nandgate/Homebrew-HW/readme.md

Hardware files for the 8-bit homebrew project.

* Each folder contains the KiCad project for a processor/board.
* Under the PLD there is a folder with the WinCUPL projects for the PLD for each board.
