nandgate/Homebrew-HW/CPU_TESTER/CPU_TESTER.pdf

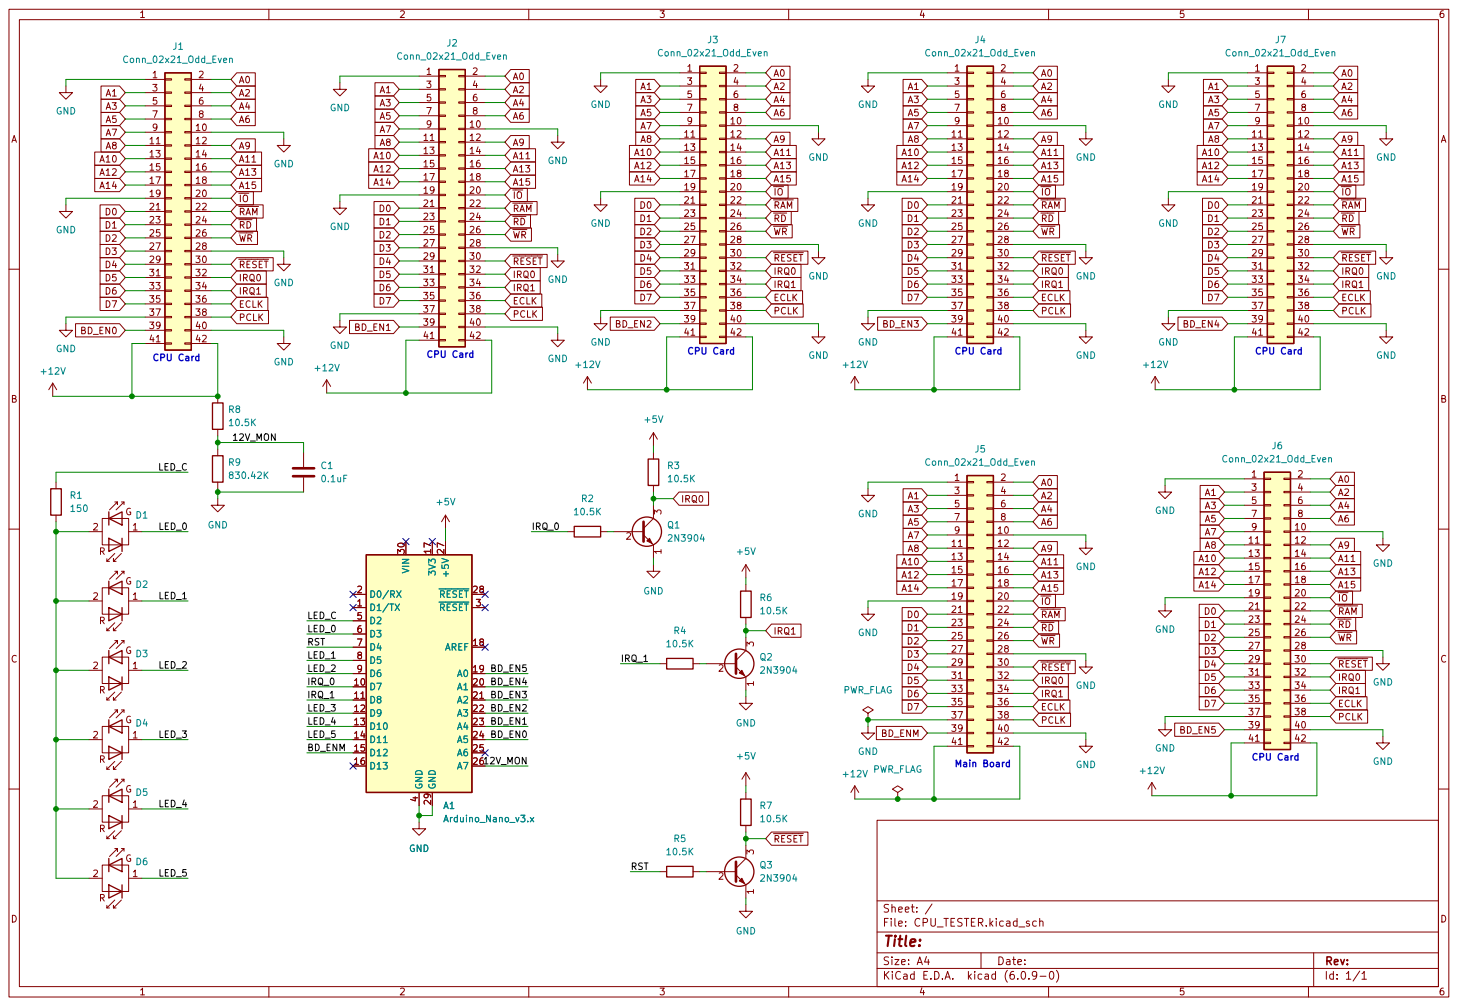
[picture p1: page 1]

J2 Conn_02x21_Odd_Even GND GND GND GND
