nandgate/Homebrew-HW/cpu8085/cpu8085.pdf

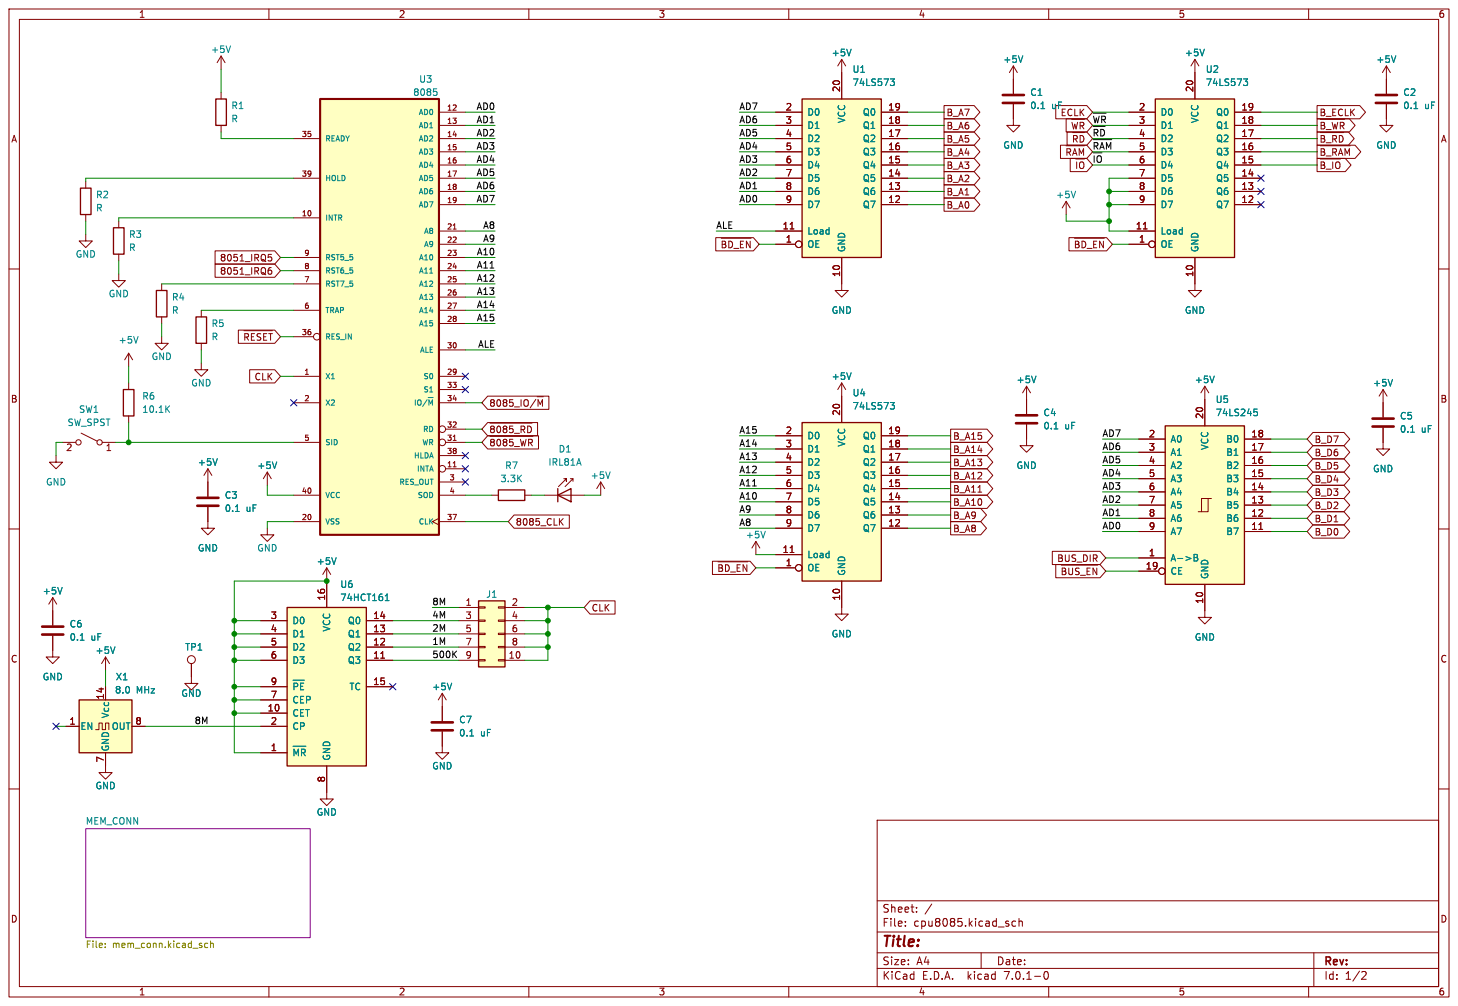
[picture p2: page 1]

Id: 1/2 Title: File: cpu8085.kicad_sch Sheet: / MEM_CONN

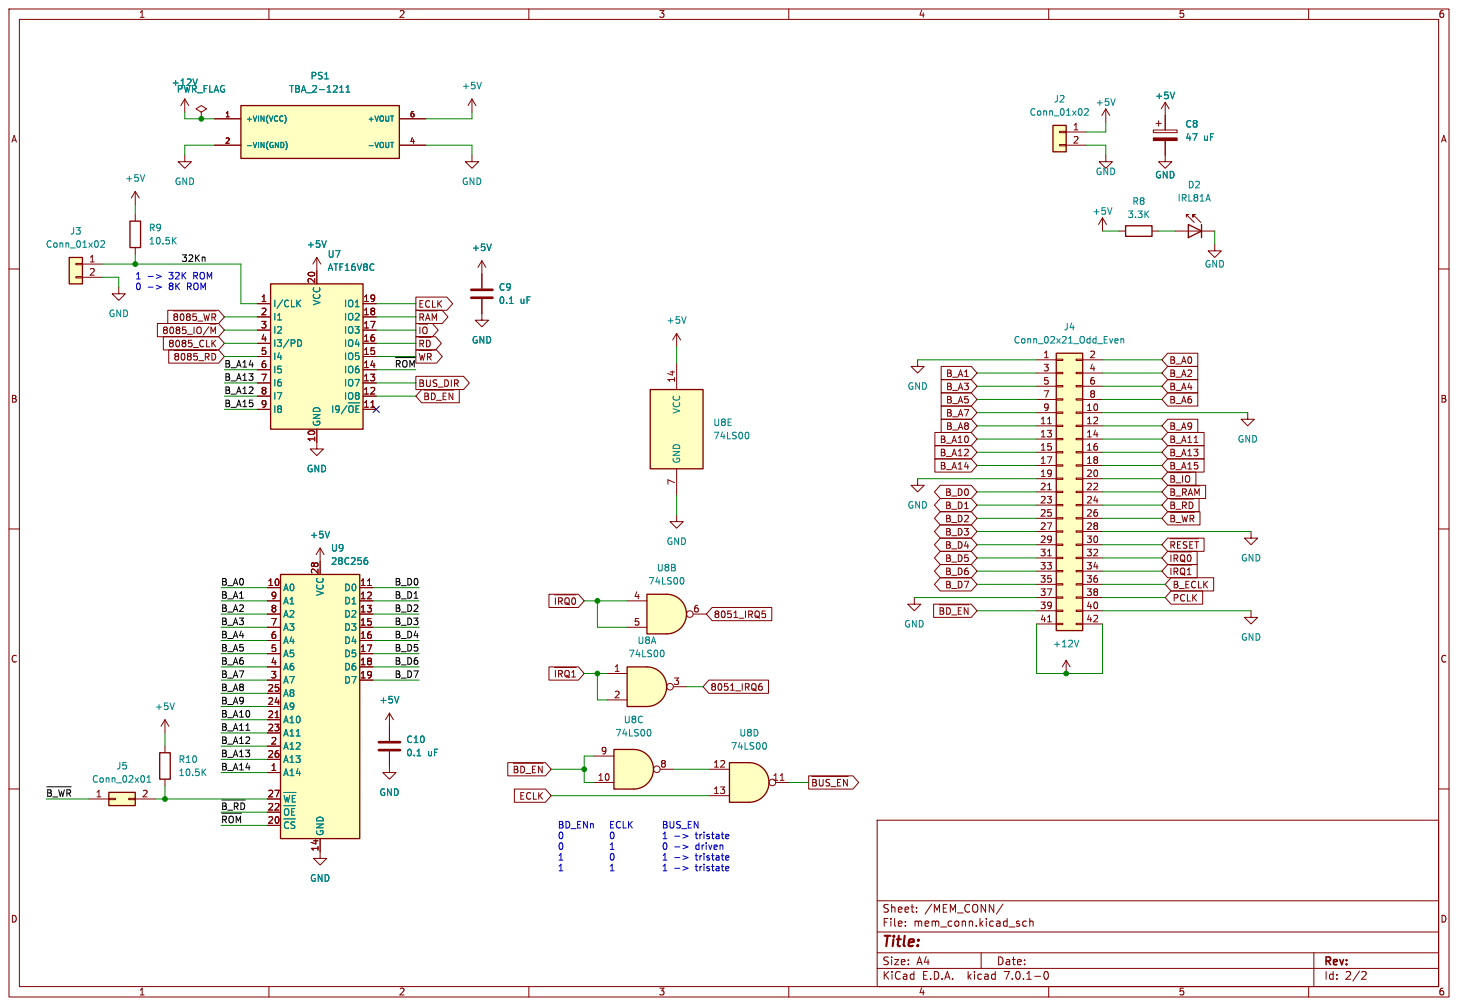
[picture p3: page 2]
