nandgate/Homebrew-HW/cpu6502/cpu6502.pdf

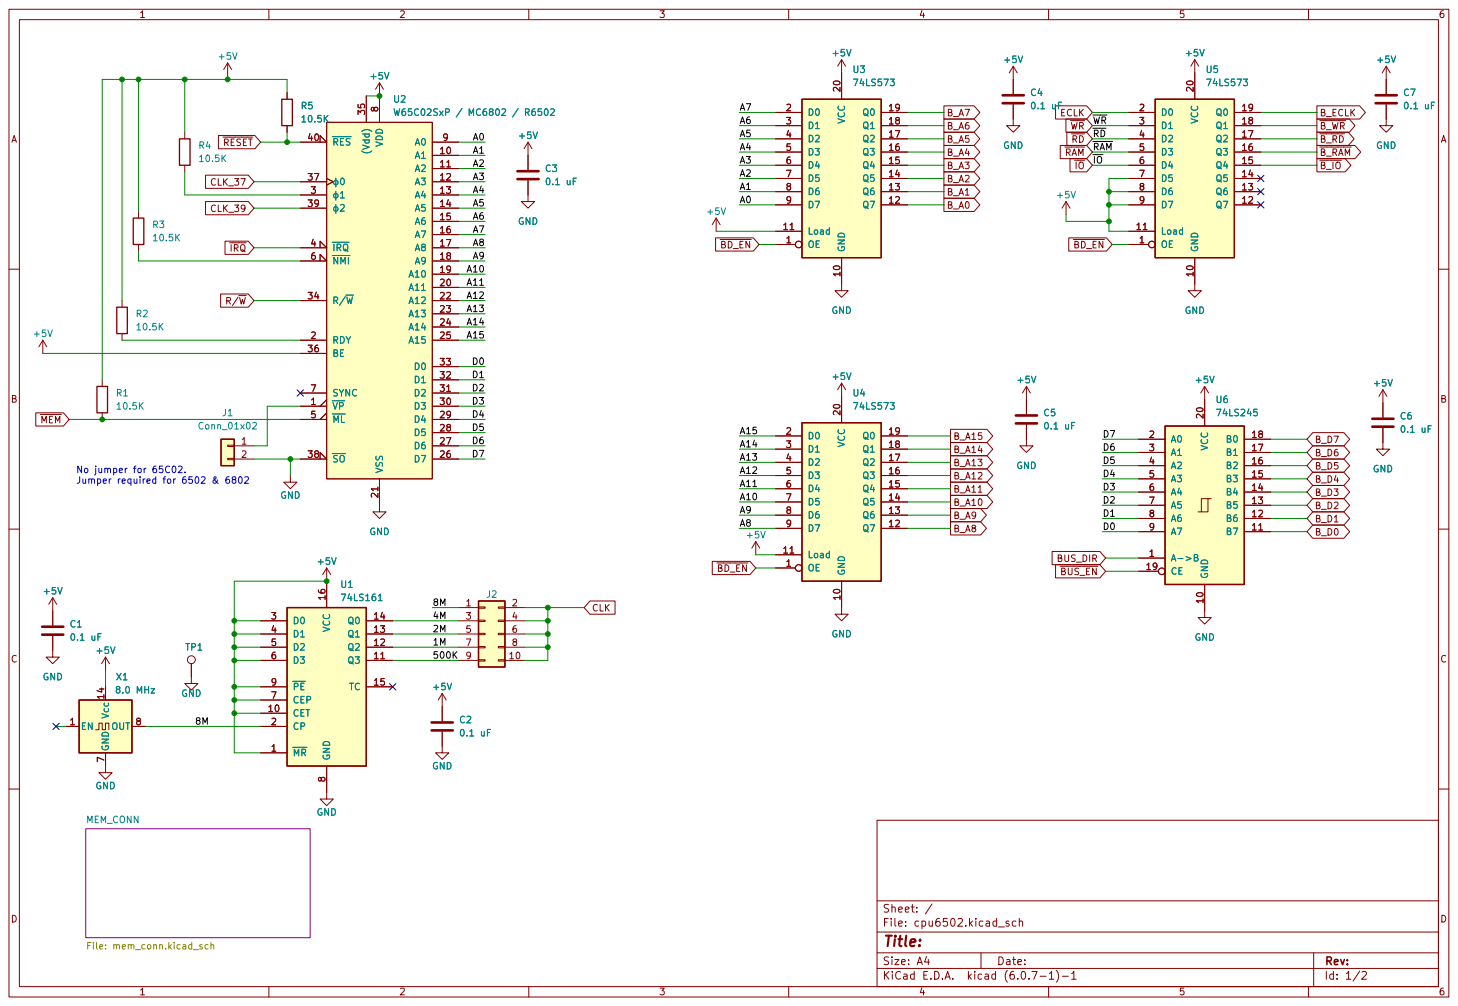
[picture p4: page 1]

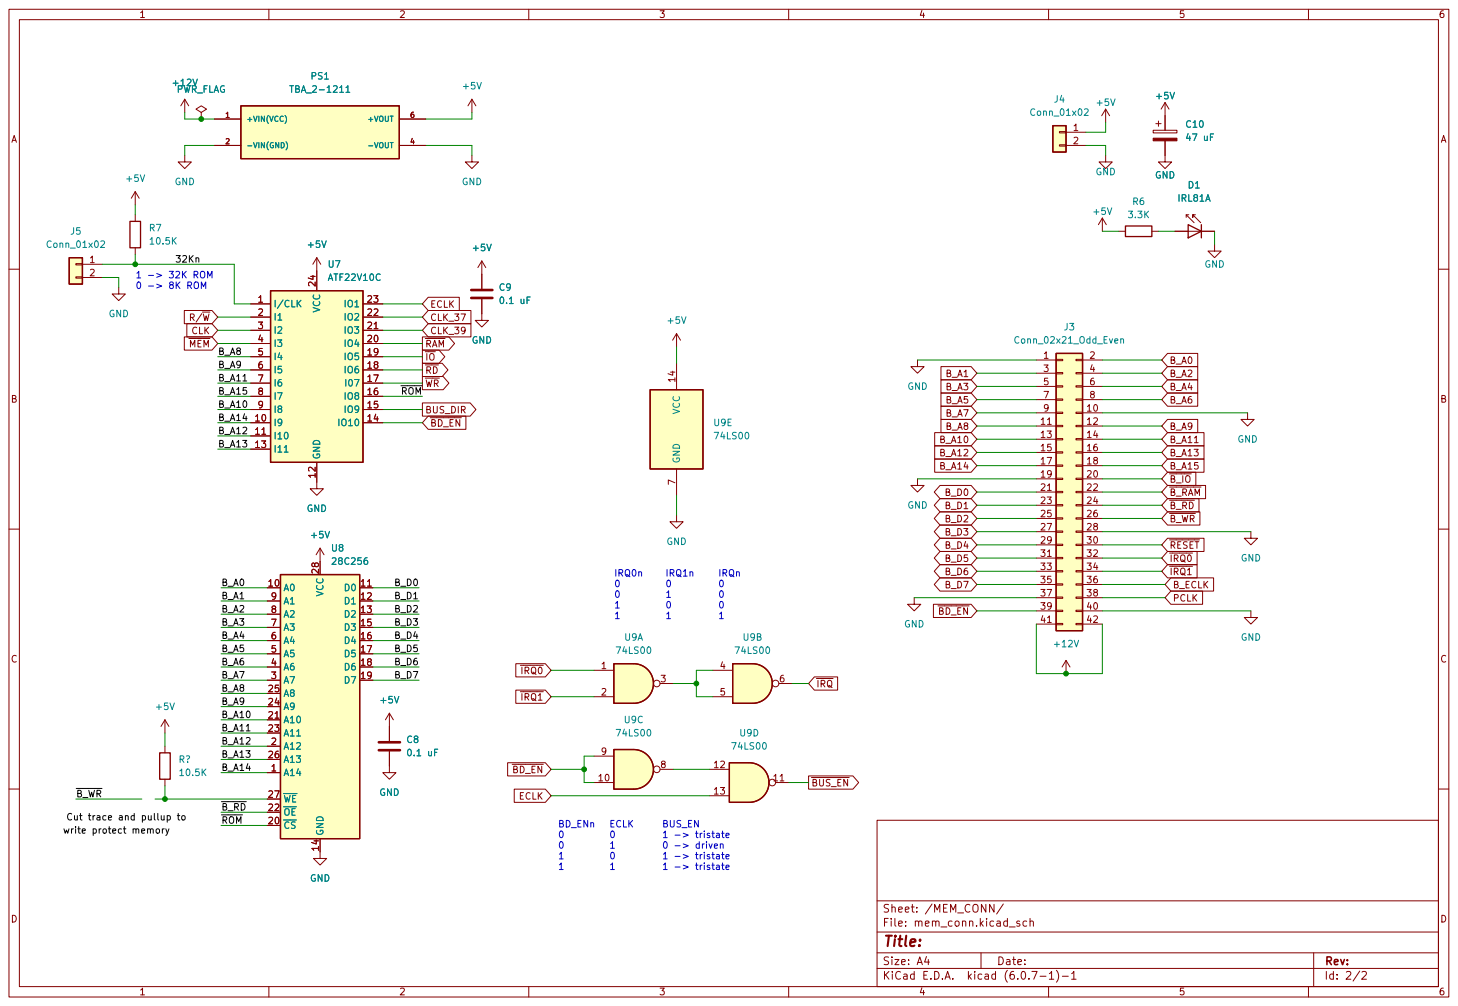
[picture p5: page 2]

J3 Conn_02x21_Odd_Even +12V GND GND GND GND

Cut trace and pullup to
write protect memory
