nandgate/Homebrew-HW/cpuZ80/cpuZ80.pdf

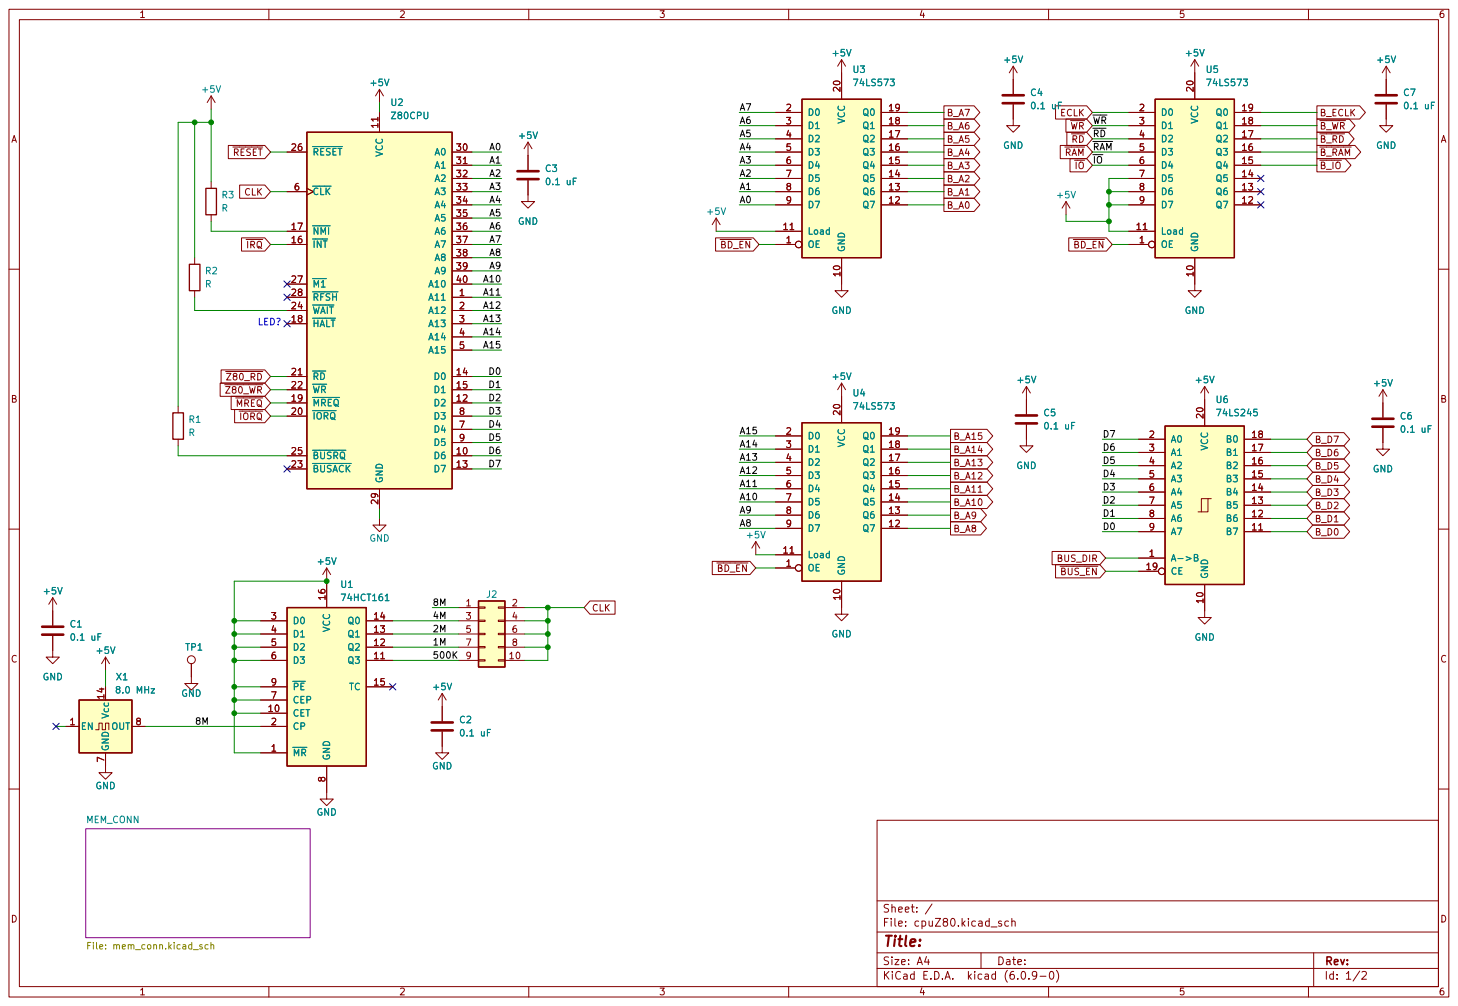
[picture p6: page 1]

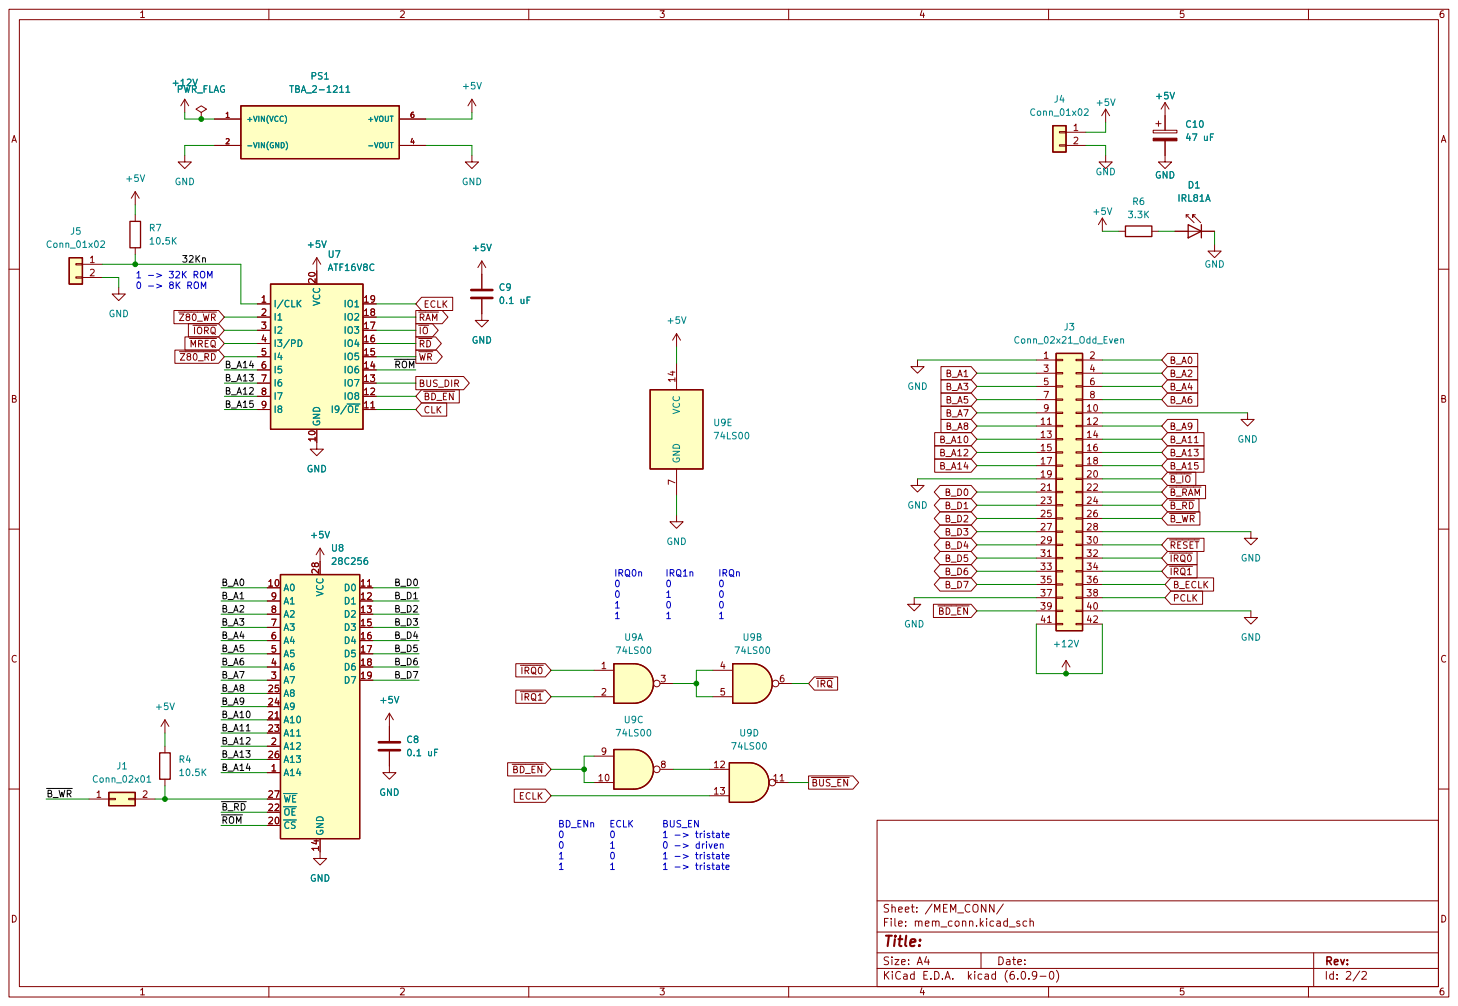
[picture p7: page 2]
