nandgate/Homebrew-HW/cpu8085/cpu8085.kicad_pcb

## KiCad design cpu8085/cpu8085.kicad_pcb (2023-04-04)

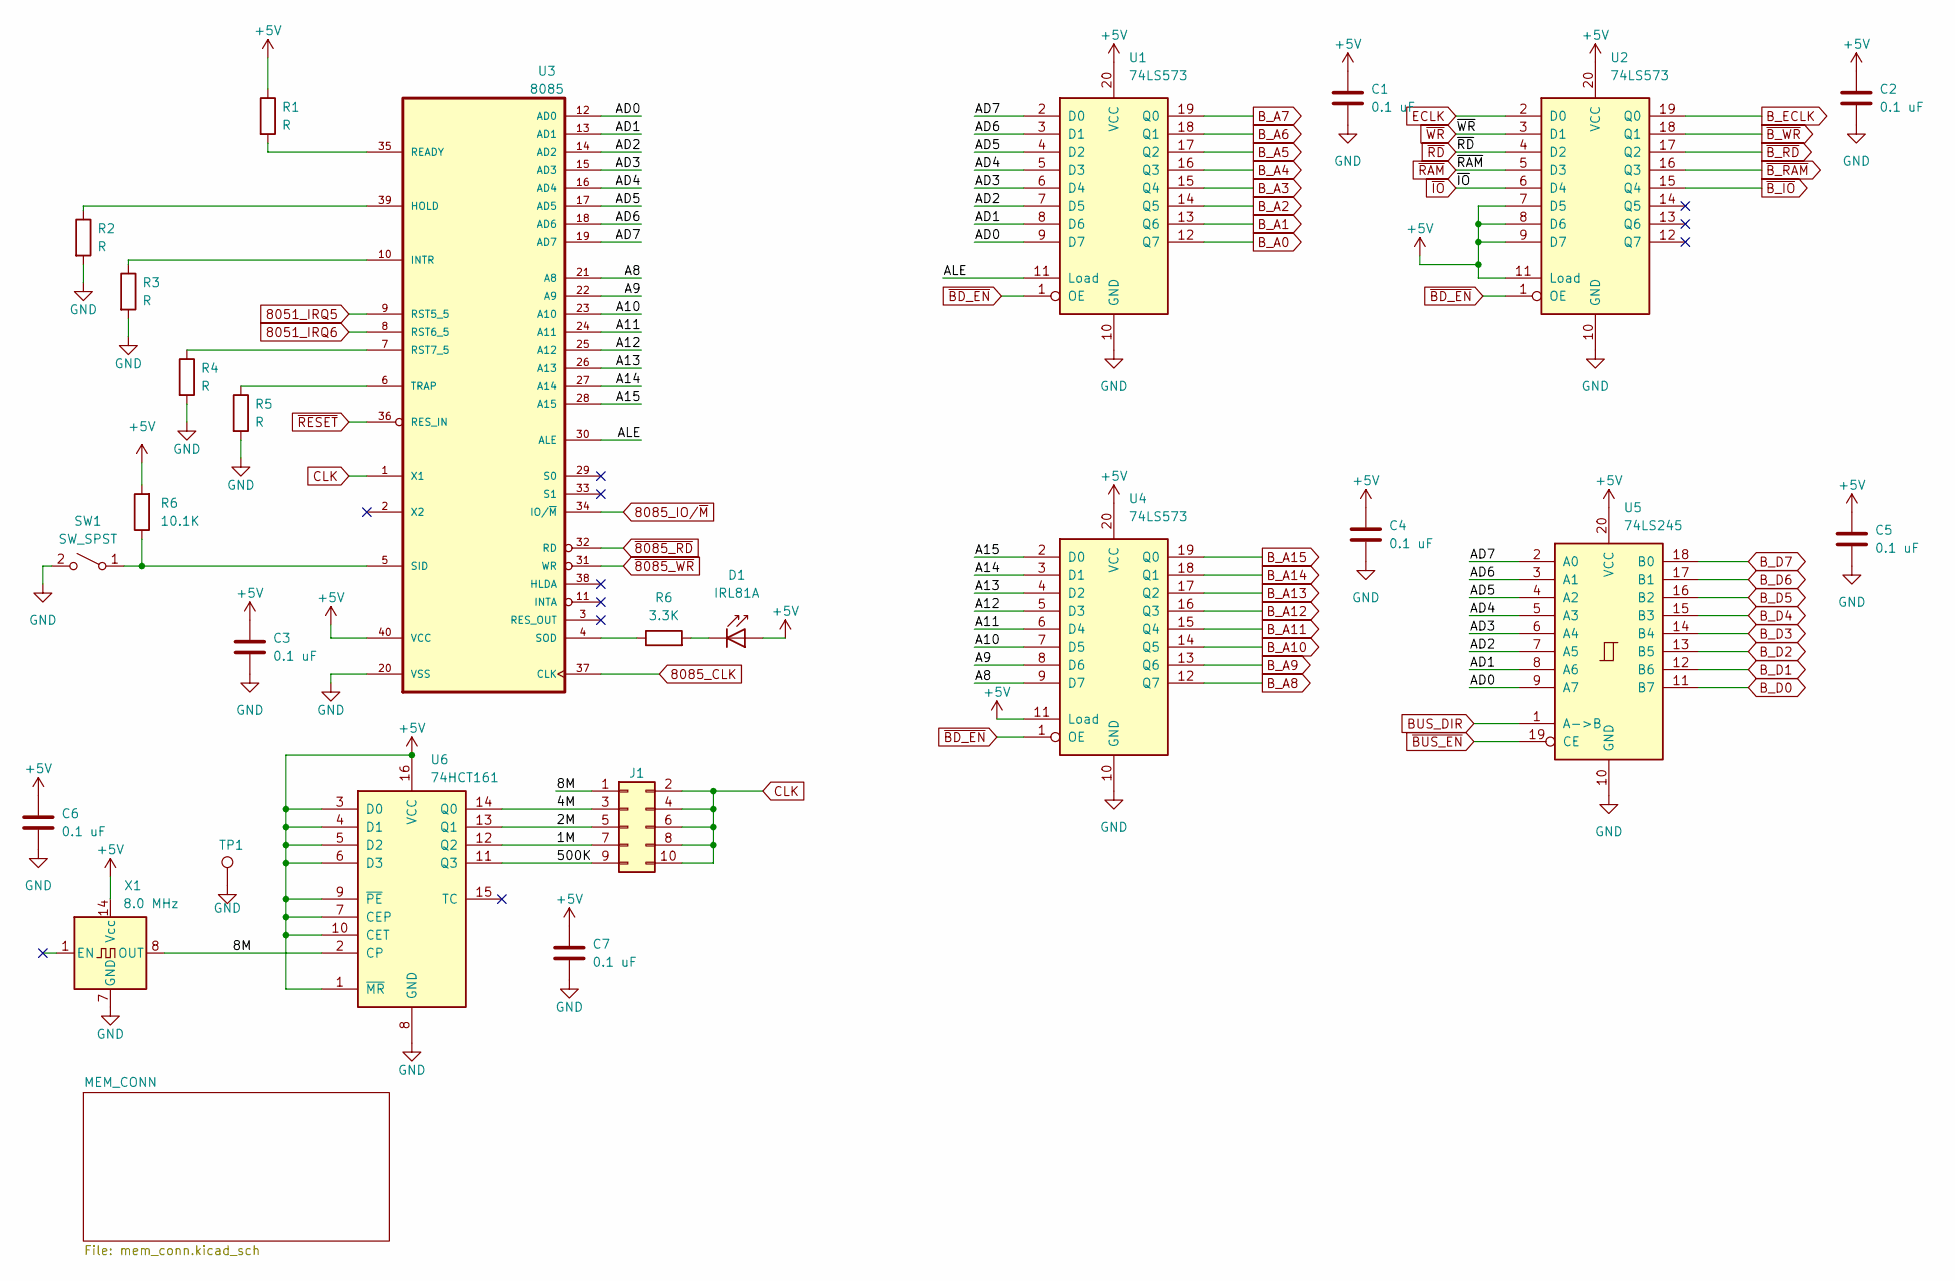
[picture p10: schematic cpu8085.kicad_sch]

Parts:
C1, C2, C3, C4, C5, C6, C7: 0.1 uF; C_Rect_L7.2mm_W3.0mm_P5.00mm_FKS2_FKP2_MKS2_MKP2
D1: IRL81A; LED_D5.0mm
J1: Conn_02x05_Odd_Even; PinHeader_2x05_P2.54mm_Vertical
R1, R2, R3, R4, R5: R; R_Axial_DIN0207_L6.3mm_D2.5mm_P10.16mm_Horizontal
R6: 10.1K; R_Axial_DIN0207_L6.3mm_D2.5mm_P10.16mm_Horizontal
SW1: SW_SPST; SW_DIP_SPSTx01_Slide_9.78x4.72mm_W7.62mm_P2.54mm
TP1: TestPoint; TestPoint_Pad_2.0x2.0mm
U1, U2, U4: 74LS573; DIP-20_W7.62mm
U3: 8085; DIP-40_W15.24mm_Socket
U5: 74LS245; DIP-20_W7.62mm
U6: 74HCT161; DIP-16_W7.62mm
X1: 8.0 MHz; Oscillator_DIP-14

Connections:
8051_IRQ5: U3.9 (RST5_5); also elsewhere on the board
8051_IRQ6: U3.8 (RST6_5); also elsewhere on the board
8085_CLK: U3.37 (CLK); also elsewhere on the board
8085_IO/~M: U3.34 (IO/~M); also elsewhere on the board
/1M: J1.7, U6.12 (Q2)
/2M: J1.5, U6.13 (Q1)
/4M: J1.3, U6.14 (Q0)
/8M: J1.1, U6.2 (CP), X1.8 (OUT)
/500K: J1.9, U6.11 (Q3)
/A8: U3.21 (A8), U4.9 (D7)
/A9: U3.22 (A9), U4.8 (D6)
/A10: U3.23 (A10), U4.7 (D5)
/A11: U3.24 (A11), U4.6 (D4)
/A12: U3.25 (A12), U4.5 (D3)
/A13: U3.26 (A13), U4.4 (D2)
/A14: U3.27 (A14), U4.3 (D1)
/A15: U3.28 (A15), U4.2 (D0)
/AD0: U1.9 (D7), U3.12 (AD0), U5.9 (A7)
/AD1: U1.8 (D6), U3.13 (AD1), U5.8 (A6)
/AD2: U1.7 (D5), U3.14 (AD2), U5.7 (A5)
/AD3: U1.6 (D4), U3.15 (AD3), U5.6 (A4)
/AD4: U1.5 (D3), U3.16 (AD4), U5.5 (A3)
/AD5: U1.4 (D2), U3.17 (AD5), U5.4 (A2)
/AD6: U1.3 (D1), U3.18 (AD6), U5.3 (A1)
/AD7: U1.2 (D0), U3.19 (AD7), U5.2 (A0)
/ALE: U1.11 (Load), U3.30 (ALE)
BUS_DIR: U5.1 (A->B); also elsewhere on the board
B_A0: U1.12 (Q7); also elsewhere on the board
B_A1: U1.13 (Q6); also elsewhere on the board
B_A2: U1.14 (Q5); also elsewhere on the board
B_A3: U1.15 (Q4); also elsewhere on the board
B_A4: U1.16 (Q3); also elsewhere on the board
B_A5: U1.17 (Q2); also elsewhere on the board
B_A6: U1.18 (Q1); also elsewhere on the board
B_A7: U1.19 (Q0); also elsewhere on the board
B_A8: U4.12 (Q7); also elsewhere on the board
B_A9: U4.13 (Q6); also elsewhere on the board
B_A10: U4.14 (Q5); also elsewhere on the board
B_A11: U4.15 (Q4); also elsewhere on the board
B_A12: U4.16 (Q3); also elsewhere on the board
B_A13: U4.17 (Q2); also elsewhere on the board
B_A14: U4.18 (Q1); also elsewhere on the board
B_A15: U4.19 (Q0); also elsewhere on the board
B_D0: U5.11 (B7); also elsewhere on the board
B_D1: U5.12 (B6); also elsewhere on the board
B_D2: U5.13 (B5); also elsewhere on the board
B_D3: U5.14 (B4); also elsewhere on the board
B_D4: U5.15 (B3); also elsewhere on the board
B_D5: U5.16 (B2); also elsewhere on the board
B_D6: U5.17 (B1); also elsewhere on the board
B_D7: U5.18 (B0); also elsewhere on the board
B_ECLK: U2.19 (Q0); also elsewhere on the board
CLK: J1.2, J1.4, J1.6, J1.8, J1.10, U3.1 (X1)
ECLK: U2.2 (D0); also elsewhere on the board
GND: C1.2, C2.2, C3.2, C4.2, C5.2, C6.2, C7.2, R2.2, R3.2, R4.2, R5.2, SW1.2 (B), TP1.1, U1.10 (GND), U2.10 (GND), U3.20 (VSS), U4.10 (GND), U5.10 (GND), U6.8 (GND), X1.7 (GND); also elsewhere on the board
unnamed: R2.1, U3.39 (HOLD)
unnamed: R3.1, U3.10 (INTR)
unnamed: R1.2, U3.35 (READY)
unnamed: R4.1, U3.7 (RST7_5)
unnamed: R5.1, U3.6 (TRAP)
~8085_RD: U3.32 (RD); also elsewhere on the board
~8085_WR: U3.31 (WR); also elsewhere on the board
~BD_EN: U1.1 (OE), U2.1 (OE), U4.1 (OE); also elsewhere on the board
~BUS_EN: U5.19 (CE); also elsewhere on the board
~B_IO: U2.15 (Q4); also elsewhere on the board
~B_RAM: U2.16 (Q3); also elsewhere on the board
~B_RD: U2.17 (Q2); also elsewhere on the board
~B_WR: U2.18 (Q1); also elsewhere on the board
~IO: U2.6 (D4); also elsewhere on the board
~RAM: U2.5 (D3); also elsewhere on the board
~RD: U2.4 (D2); also elsewhere on the board
~RESET: U3.36 (RES_IN); also elsewhere on the board
~WR: U2.3 (D1); also elsewhere on the board

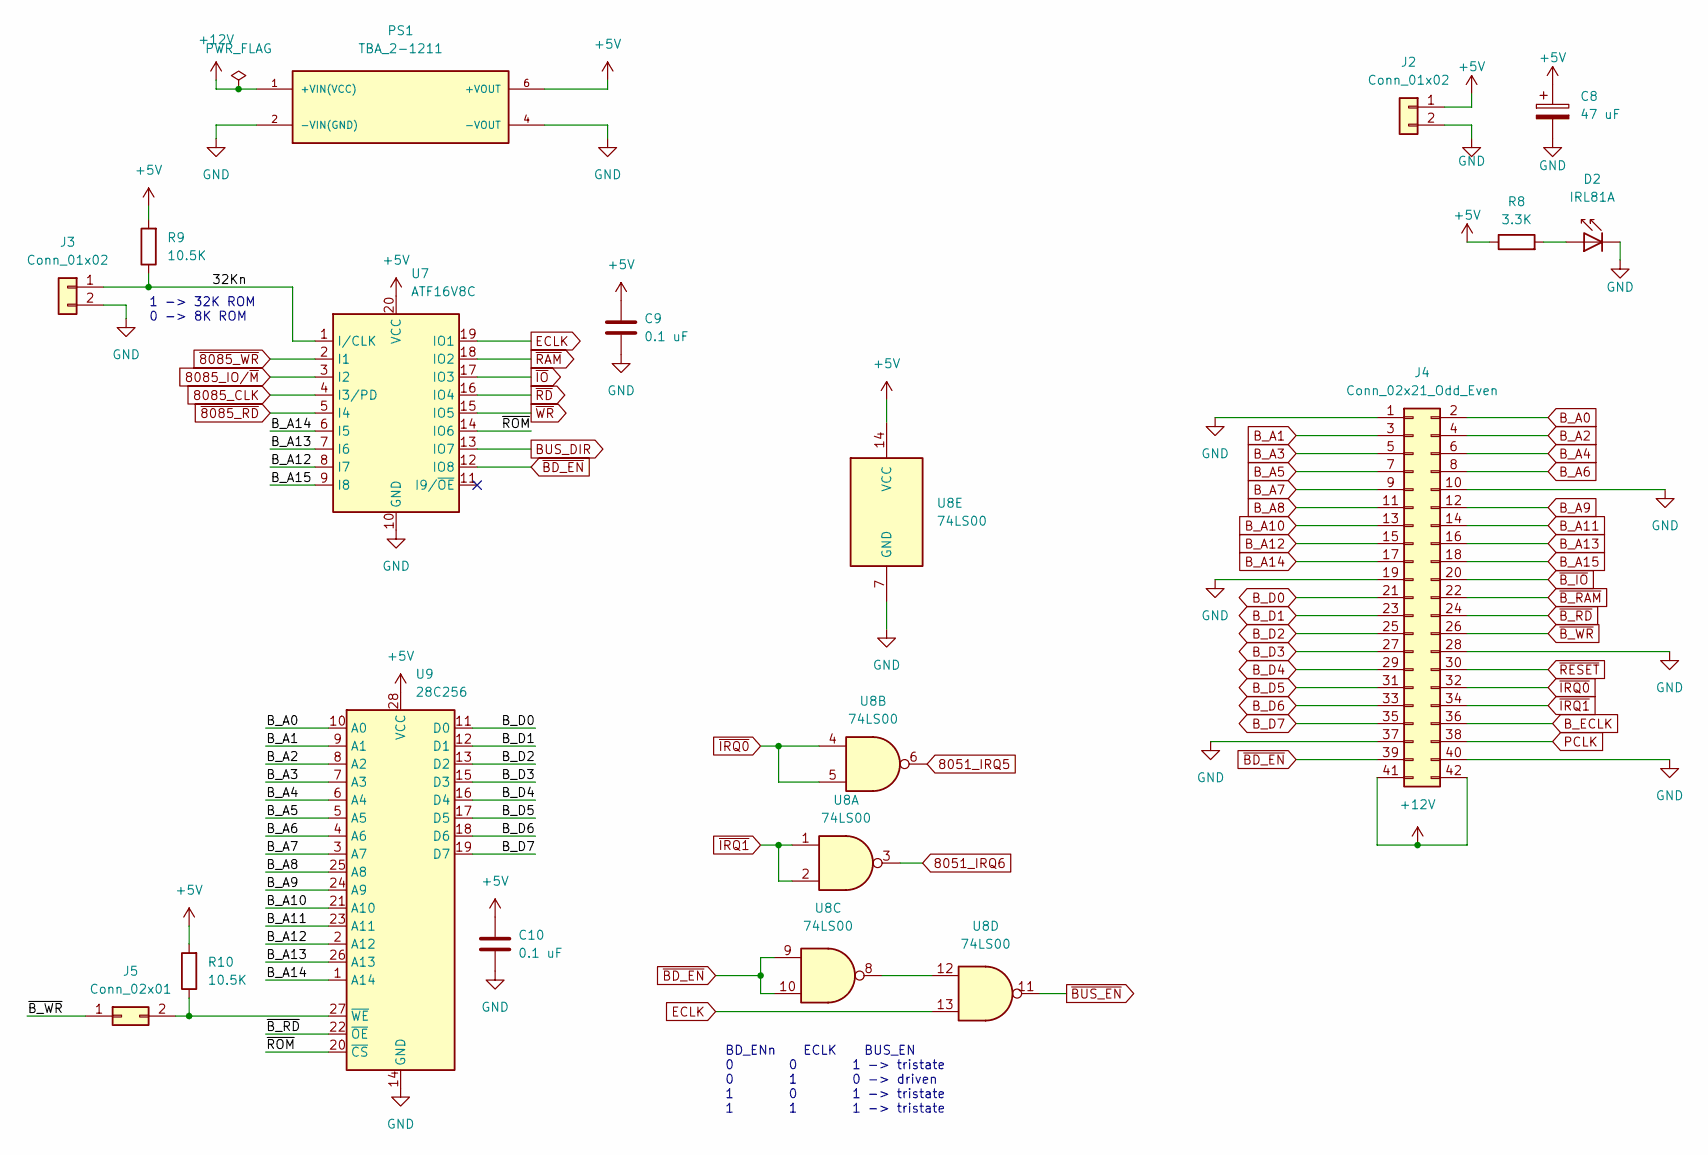
[picture p11: schematic mem_conn.kicad_sch]

Parts:
C8: 47 uF; CP_Radial_D5.0mm_P2.00mm
C9, C10: 0.1 uF; C_Rect_L7.2mm_W3.0mm_P5.00mm_FKS2_FKP2_MKS2_MKP2
D2: IRL81A; LED_D5.0mm
J2, J3: Conn_01x02; PinHeader_1x02_P2.54mm_Vertical
J4: Conn_02x21_Odd_Even; PinHeader_2x21_P2.54mm_Vertical
J5: Conn_02x01; PinHeader_1x02_P2.54mm_Vertical
PS1: TBA_2-1211; CONV_TBA_2-1211; PARTREV April 19, 2021
R8: 3.3K; R_Axial_DIN0207_L6.3mm_D2.5mm_P10.16mm_Horizontal
R9, R10: 10.5K; R_Axial_DIN0207_L6.3mm_D2.5mm_P10.16mm_Horizontal
U7: ATF16V8C; DIP-20_W7.62mm
U8: 74LS00; DIP-14_W7.62mm
U9: 28C256; DIP-28_W15.24mm

Connections:
8051_IRQ5: U8.6; also elsewhere on the board
8051_IRQ6: U8.3; also elsewhere on the board
8085_CLK: U7.4 (I3/PD); also elsewhere on the board
8085_IO/~M: U7.3 (I2); also elsewhere on the board
+12V: J4.41, J4.42, PS1.1 (+VIN(VCC))
/MEM_CONN/32Kn: J3.1, R9.1, U7.1 (I/CLK)
/MEM_CONN/~ROM: U7.14 (IO6), U9.20 (~CS)
BUS_DIR: U7.13 (IO7); also elsewhere on the board
B_A0: J4.2, U9.10 (A0); also elsewhere on the board
B_A1: J4.3, U9.9 (A1); also elsewhere on the board
B_A2: J4.4, U9.8 (A2); also elsewhere on the board
B_A3: J4.5, U9.7 (A3); also elsewhere on the board
B_A4: J4.6, U9.6 (A4); also elsewhere on the board
B_A5: J4.7, U9.5 (A5); also elsewhere on the board
B_A6: J4.8, U9.4 (A6); also elsewhere on the board
B_A7: J4.9, U9.3 (A7); also elsewhere on the board
B_A8: J4.11, U9.25 (A8); also elsewhere on the board
B_A9: J4.12, U9.24 (A9); also elsewhere on the board
B_A10: J4.13, U9.21 (A10); also elsewhere on the board
B_A11: J4.14, U9.23 (A11); also elsewhere on the board
B_A12: J4.15, U7.8 (I7), U9.2 (A12); also elsewhere on the board
B_A13: J4.16, U7.7 (I6), U9.26 (A13); also elsewhere on the board
B_A14: J4.17, U7.6 (I5), U9.1 (A14); also elsewhere on the board
B_A15: J4.18, U7.9 (I8); also elsewhere on the board
B_D0: J4.21, U9.11 (D0); also elsewhere on the board
B_D1: J4.23, U9.12 (D1); also elsewhere on the board
B_D2: J4.25, U9.13 (D2); also elsewhere on the board
B_D3: J4.27, U9.15 (D3); also elsewhere on the board
B_D4: J4.29, U9.16 (D4); also elsewhere on the board
B_D5: J4.31, U9.17 (D5); also elsewhere on the board
B_D6: J4.33, U9.18 (D6); also elsewhere on the board
B_D7: J4.35, U9.19 (D7); also elsewhere on the board
B_ECLK: J4.36; also elsewhere on the board
ECLK: U7.19 (IO1), U8.13; also elsewhere on the board
GND: C8.2, C9.2, C10.2, D2.1 (K), J2.2, J3.2, J4.1, J4.10, J4.19, J4.28, J4.37, J4.40, PS1.2 (-VIN(GND)), PS1.4 (-VOUT), U7.10 (GND), U8.7 (GND), U9.14 (GND); also elsewhere on the board
unnamed: D2.2 (A), R8.2
unnamed: J5.2, R10.1, U9.27 (~WE)
unnamed: U8.8, U8.12
PCLK: J4.38
~8085_RD: U7.5 (I4); also elsewhere on the board
~8085_WR: U7.2 (I1); also elsewhere on the board
~BD_EN: J4.39, U7.12 (IO8), U8.9, U8.10; also elsewhere on the board
~BUS_EN: U8.11; also elsewhere on the board
~B_IO: J4.20; also elsewhere on the board
~B_RAM: J4.22; also elsewhere on the board
~B_RD: J4.24, U9.22 (~OE); also elsewhere on the board
~B_WR: J4.26, J5.1; also elsewhere on the board
~IO: U7.17 (IO3); also elsewhere on the board
~IRQ0: J4.32, U8.4, U8.5
~IRQ1: J4.34, U8.1, U8.2
~RAM: U7.18 (IO2); also elsewhere on the board
~RD: U7.16 (IO4); also elsewhere on the board
~RESET: J4.30; also elsewhere on the board
~WR: U7.15 (IO5); also elsewhere on the board

Notes on the sheet:
1 -> 32K ROM 0 -> 8K ROM
BD_ENn ECLK BUS_EN 0 0 1 -> tristate 0 1 0 -> driven 1 0 1 -> tristate 1 1 1 -> tristate

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
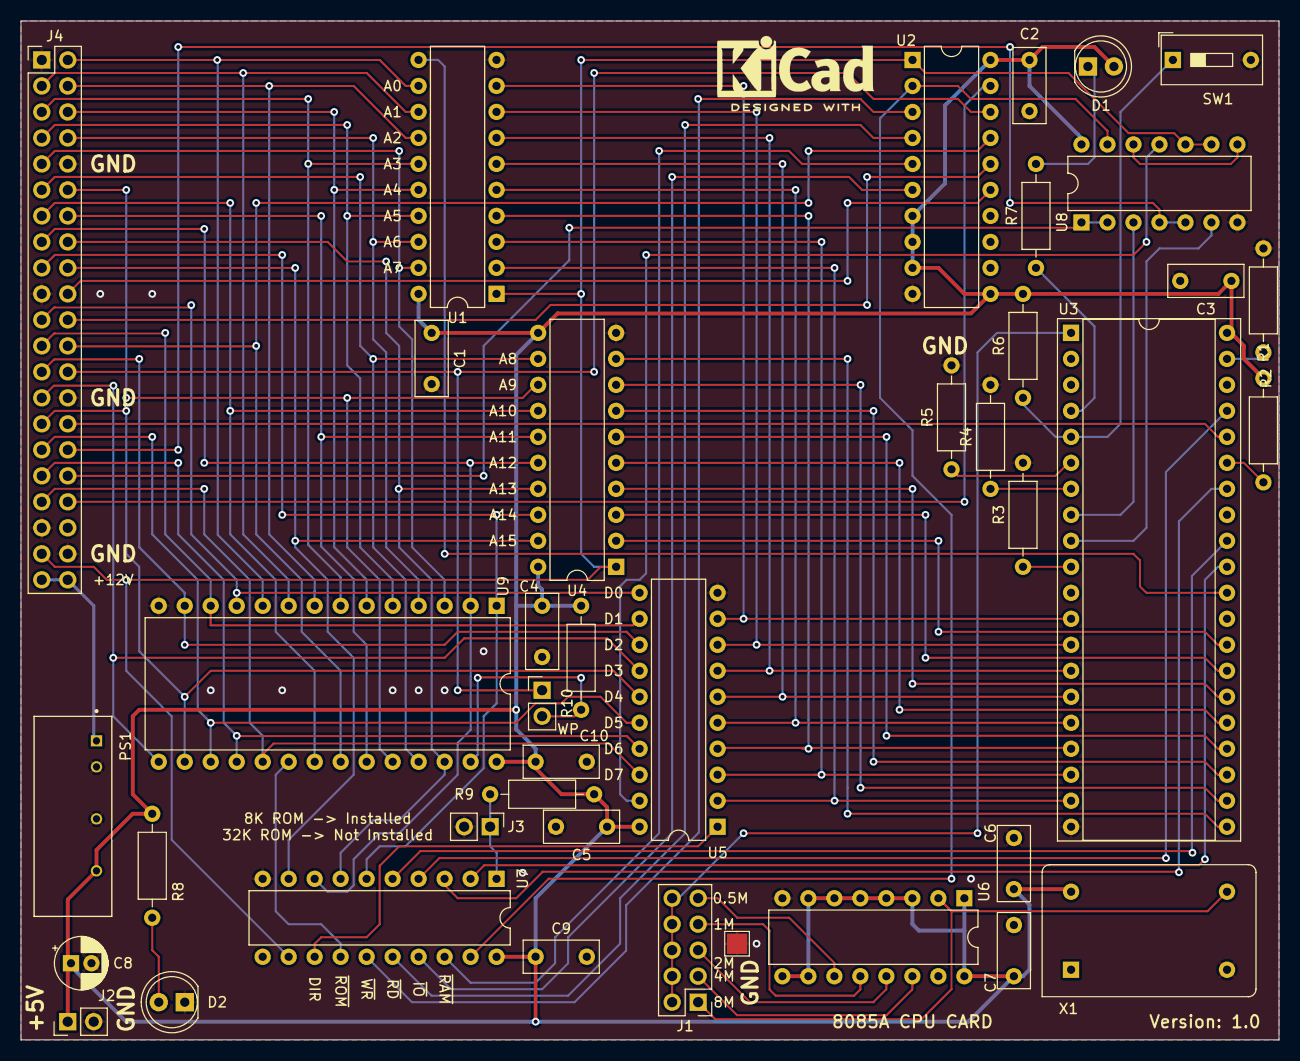
[picture p12: board cpu8085.kicad_pcb from above]

Board: 2 copper layers, 122.9 x 99.6 mm, 40 parts (0 on the bottom side), 85 nets.

Other parts of the board:
R7: 3.3K; R_Axial_DIN0207_L6.3mm_D2.5mm_P10.16mm_Horizontal
