nandgate/Homebrew-HW/CPU_TESTER/CPU_TESTER.kicad_pcb

## KiCad design CPU_TESTER/CPU_TESTER.kicad_pcb (2022-10-13)

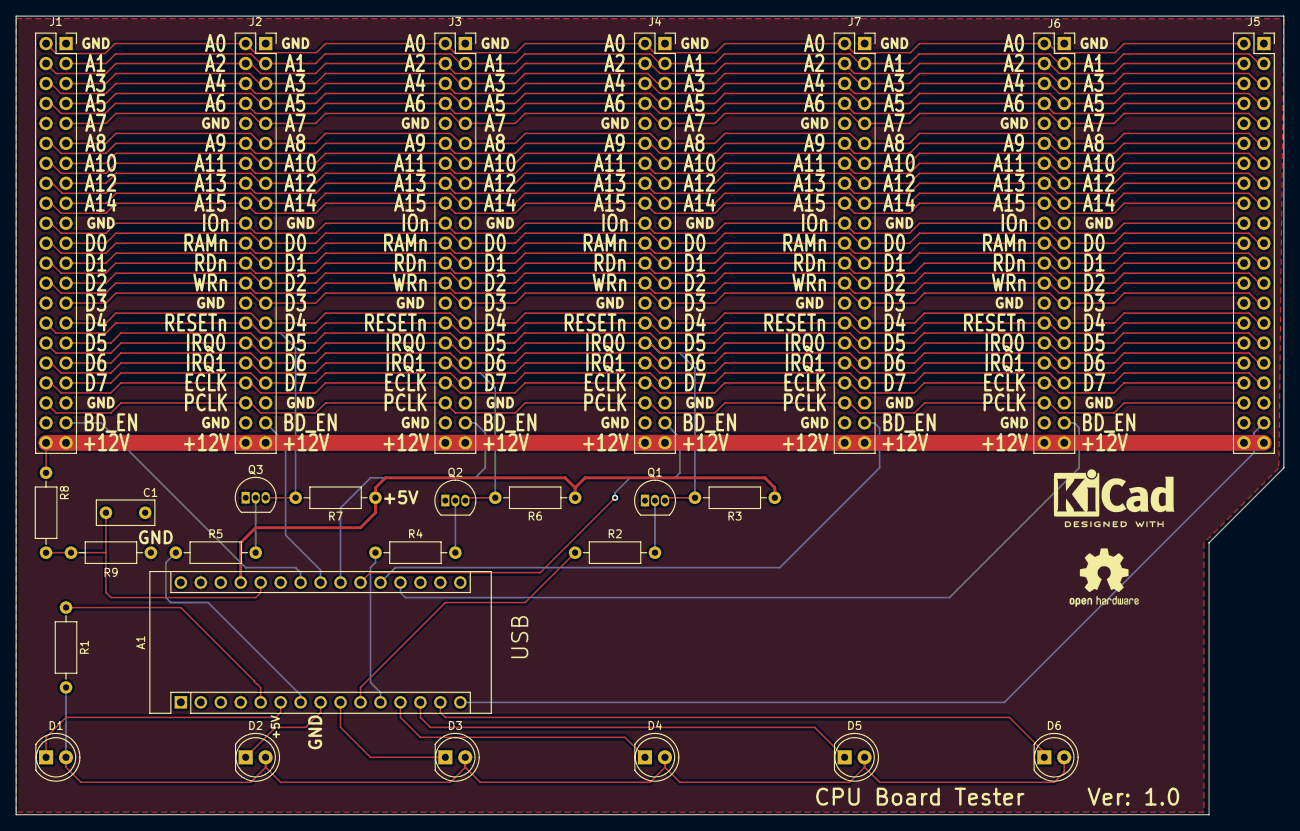
[picture p13: board CPU_TESTER.kicad_pcb from above]

Board: 2 copper layers, 161.3 x 101.6 mm, 27 parts (0 on the bottom side), 58 nets.

Parts:
A1: Arduino_Nano_v3.x; Arduino_Nano
C1: 0.1uF; C_Rect_L7.2mm_W3.0mm_P5.00mm_FKS2_FKP2_MKS2_MKP2
D1, D2, D3, D4, D5, D6: BiColorLED_RG; LED_D5.0mm_FlatTop
J1, J2, J3, J4, J5, J6, J7: Conn_02x21_Odd_Even; PinSocket_2x21_P2.54mm_Vertical
Q1, Q2, Q3: 2N3904; TO-92_Inline
R1, R8, R9: R; R_Axial_DIN0207_L6.3mm_D2.5mm_P10.16mm_Horizontal
R2, R3, R4, R5, R6, R7: 10.1K; R_Axial_DIN0207_L6.3mm_D2.5mm_P10.16mm_Horizontal

Connections:
+5V: A1.27 (+5V), R3.1, R6.1, R7.1
+12V: J1.41, J1.42, J2.41, J2.42, J3.41, J3.42, J4.41, J4.42, J5.41, J5.42, J6.41, J6.42, J7.41, J7.42, R8.1
/12V_MON: A1.26 (A7), C1.1, R8.2, R9.1
/IRQ_0: A1.10 (D7), R2.1
/IRQ_1: A1.11 (D8), R4.1
/LED_0: A1.6 (D3), D1.1
/LED_1: A1.8 (D5), D2.1
/LED_2: A1.9 (D6), D3.1
/LED_3: A1.12 (D9), D4.1
/LED_4: A1.13 (D10), D5.1
/LED_5: A1.14 (D11), D6.1
/LED_C: A1.5 (D2), R1.1
/RST: A1.7 (D4), R5.1
A0: J1.2, J2.2, J3.2, J4.2, J5.2, J6.2, J7.2
A1: J1.3, J2.3, J3.3, J4.3, J5.3, J6.3, J7.3
A2: J1.4, J2.4, J3.4, J4.4, J5.4, J6.4, J7.4
A3: J1.5, J2.5, J3.5, J4.5, J5.5, J6.5, J7.5
A4: J1.6, J2.6, J3.6, J4.6, J5.6, J6.6, J7.6
A5: J1.7, J2.7, J3.7, J4.7, J5.7, J6.7, J7.7
A6: J1.8, J2.8, J3.8, J4.8, J5.8, J6.8, J7.8
A7: J1.9, J2.9, J3.9, J4.9, J5.9, J6.9, J7.9
A8: J1.11, J2.11, J3.11, J4.11, J5.11, J6.11, J7.11
A9: J1.12, J2.12, J3.12, J4.12, J5.12, J6.12, J7.12
A10: J1.13, J2.13, J3.13, J4.13, J5.13, J6.13, J7.13
A11: J1.14, J2.14, J3.14, J4.14, J5.14, J6.14, J7.14
A12: J1.15, J2.15, J3.15, J4.15, J5.15, J6.15, J7.15
A13: J1.16, J2.16, J3.16, J4.16, J5.16, J6.16, J7.16
A14: J1.17, J2.17, J3.17, J4.17, J5.17, J6.17, J7.17
A15: J1.18, J2.18, J3.18, J4.18, J5.18, J6.18, J7.18
BD_EN0: A1.24 (A5), J1.39
BD_EN1: A1.23 (A4), J2.39
BD_EN2: A1.22 (A3), J3.39
BD_EN3: A1.21 (A2), J4.39
BD_EN4: A1.20 (A1), J7.39
BD_EN5: A1.19 (A0), J6.39
BD_ENM: A1.15 (D12), J5.39
D0: J1.21, J2.21, J3.21, J4.21, J5.21, J6.21, J7.21
D1: J1.23, J2.23, J3.23, J4.23, J5.23, J6.23, J7.23
D2: J1.25, J2.25, J3.25, J4.25, J5.25, J6.25, J7.25
D3: J1.27, J2.27, J3.27, J4.27, J5.27, J6.27, J7.27
D4: J1.29, J2.29, J3.29, J4.29, J5.29, J6.29, J7.29
D5: J1.31, J2.31, J3.31, J4.31, J5.31, J6.31, J7.31
D6: J1.33, J2.33, J3.33, J4.33, J5.33, J6.33, J7.33
D7: J1.35, J2.35, J3.35, J4.35, J5.35, J6.35, J7.35
ECLK: J1.36, J2.36, J3.36, J4.36, J5.36, J6.36, J7.36
GND: A1.4 (GND), A1.29 (GND), C1.2, J1.1, J1.10, J1.19, J1.28, J1.37, J1.40, J2.1, J2.10, J2.19, J2.28, J2.37, J2.40, J3.1, J3.10, J3.19, J3.28, J3.37, J3.40, J4.1, J4.10, J4.19, J4.28, J4.37, J4.40, J5.1, J5.10, J5.19, J5.28, J5.37, J5.40, J6.1, J6.10, J6.19, J6.28, J6.37, J6.40, J7.1, J7.10, J7.19, J7.28, J7.37, J7.40, Q1.1 (E), Q2.1 (E), Q3.1 (E), R9.2
IRQ0: J1.32, J2.32, J3.32, J4.32, J5.32, J6.32, J7.32, Q1.3 (C), R3.2
IRQ1: J1.34, J2.34, J3.34, J4.34, J5.34, J6.34, J7.34, Q2.3 (C), R6.2
unnamed: D1.2, D2.2, D3.2, D4.2, D5.2, D6.2, R1.2
unnamed: Q1.2 (B), R2.2
unnamed: Q2.2 (B), R4.2
unnamed: Q3.2 (B), R5.2
PCLK: J1.38, J2.38, J3.38, J4.38, J5.38, J6.38, J7.38
~IO: J1.20, J2.20, J3.20, J4.20, J5.20, J6.20, J7.20
~RAM: J1.22, J2.22, J3.22, J4.22, J5.22, J6.22, J7.22
~RD: J1.24, J2.24, J3.24, J4.24, J5.24, J6.24, J7.24
~RESET: J1.30, J2.30, J3.30, J4.30, J5.30, J6.30, J7.30, Q3.3 (C), R7.2
~WR: J1.26, J2.26, J3.26, J4.26, J5.26, J6.26, J7.26
