nandgate/Homebrew-HW/cpuZ80/cpuZ80.kicad_pcb

## KiCad design cpuZ80/cpuZ80.kicad_pcb (continued)

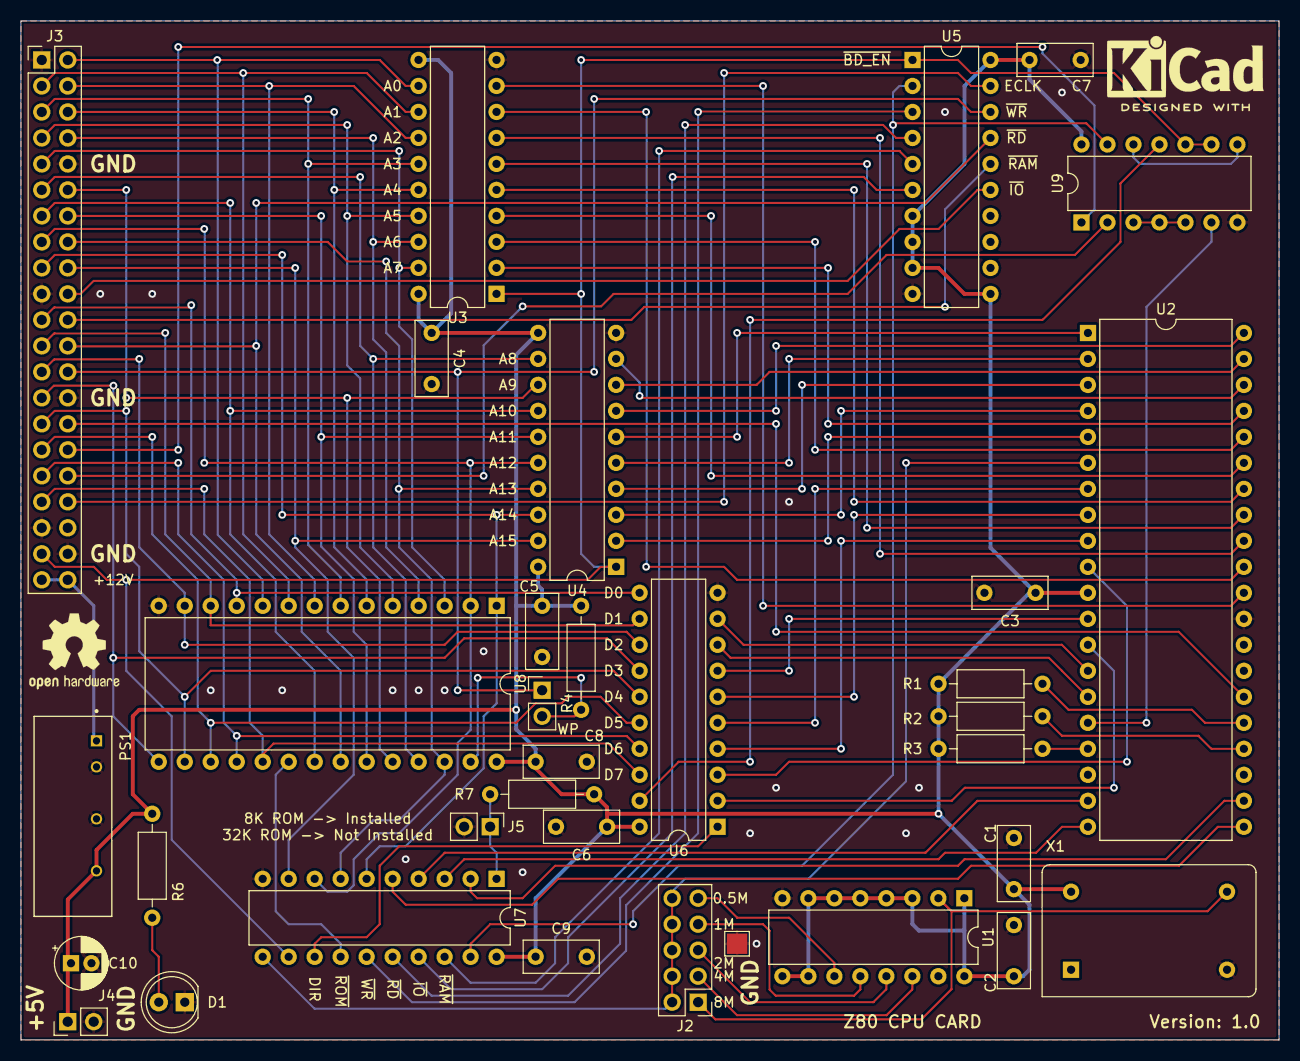
[picture p16: board cpuZ80.kicad_pcb from above]

Board: 2 copper layers, 122.9 x 99.6 mm, 34 parts (0 on the bottom side), 87 nets.
