nandgate/Homebrew-HW/cpu6502/cpu6502.kicad_pcb

## KiCad design cpu6502/cpu6502.kicad_pcb (2022-09-05)

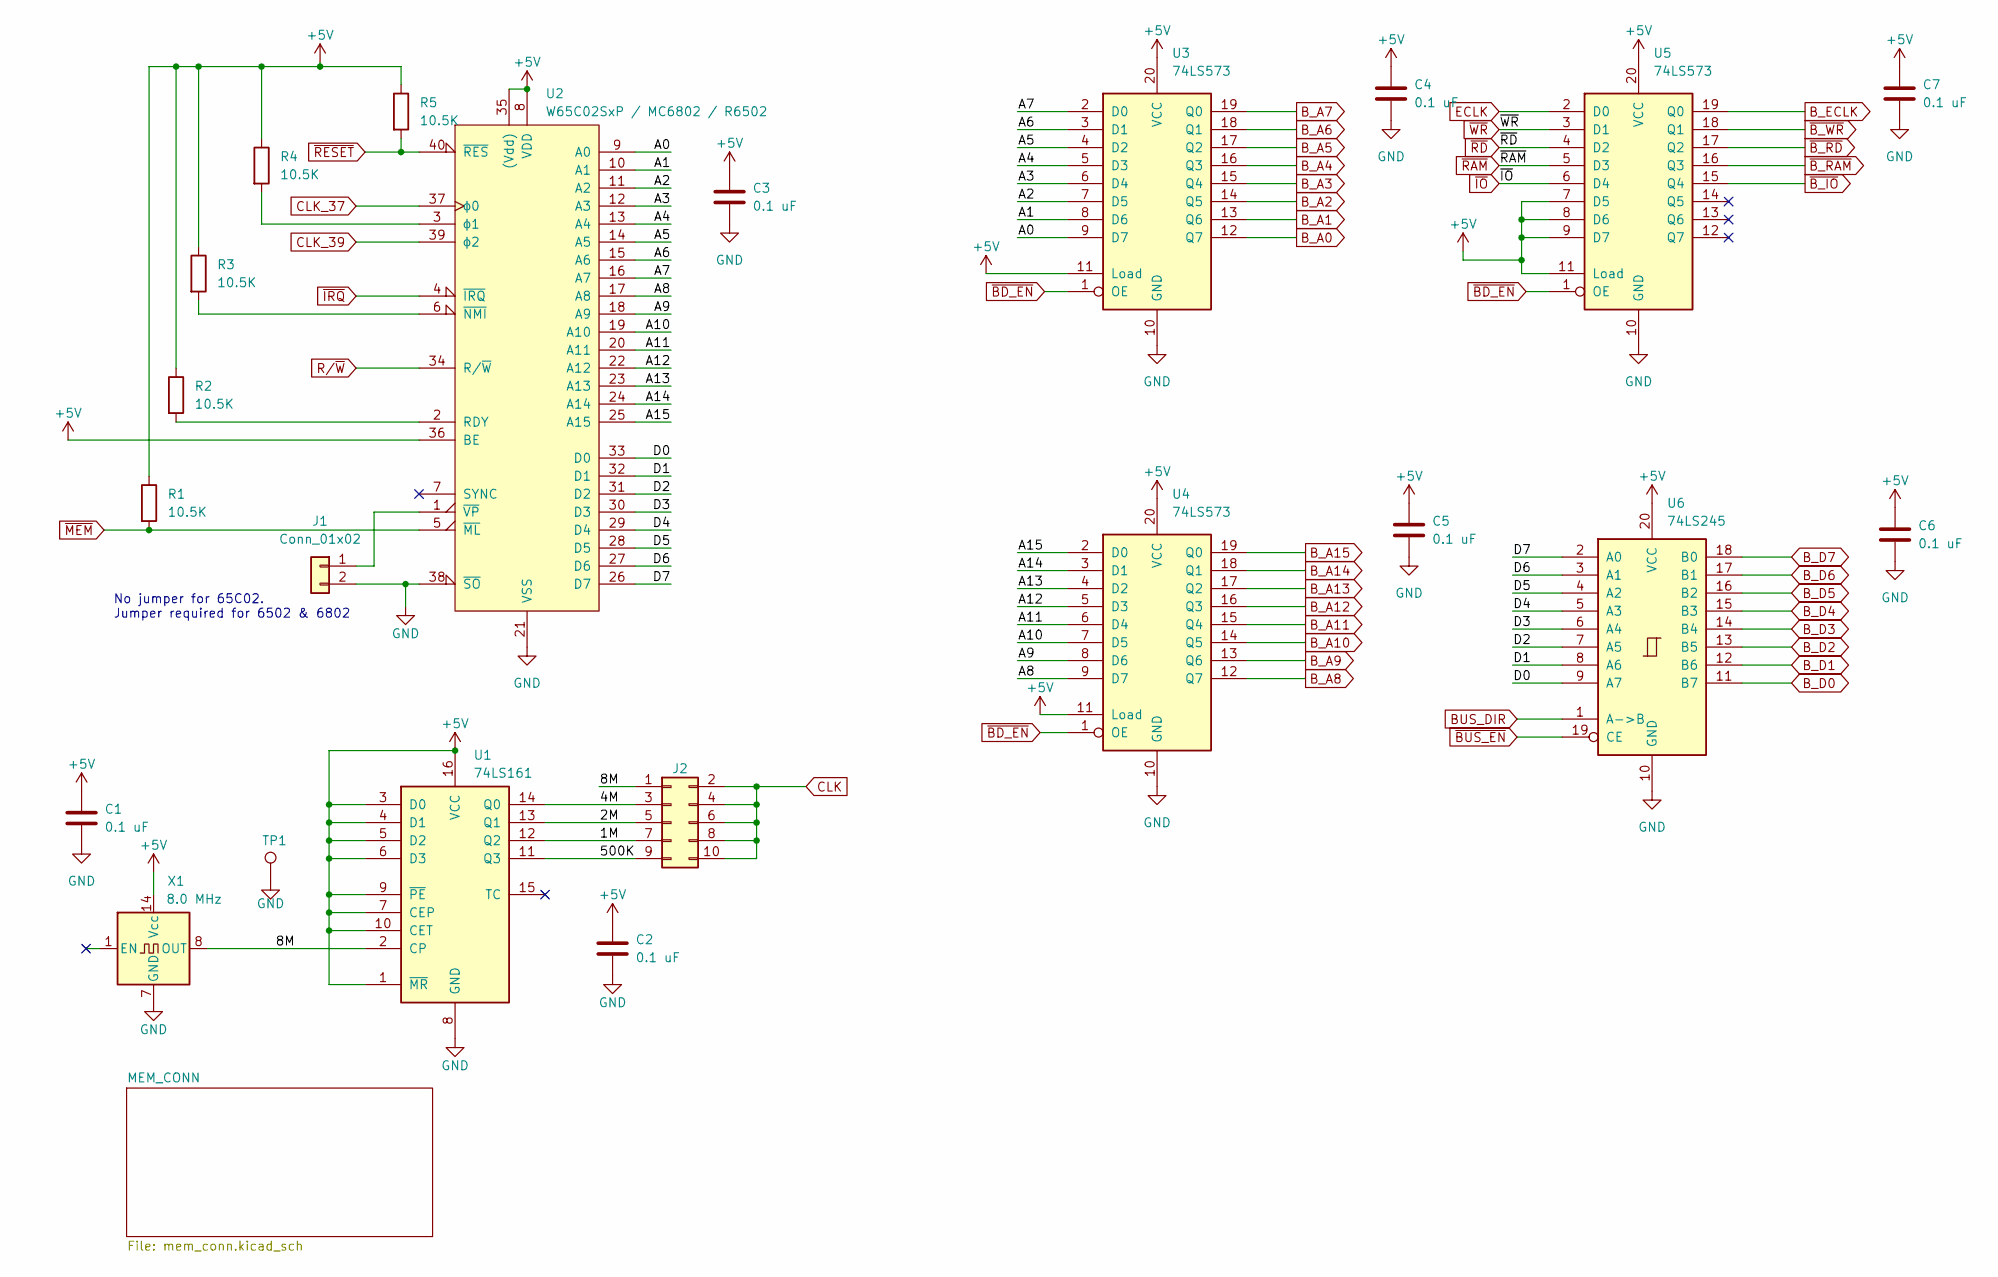
[picture p17: schematic cpu6502.kicad_sch]

Parts:
C1, C2, C3, C4, C5, C6, C7: 0.1 uF; C_Rect_L7.2mm_W3.0mm_P5.00mm_FKS2_FKP2_MKS2_MKP2
J1: Conn_01x02; PinHeader_1x02_P2.54mm_Vertical
J2: Conn_02x05_Odd_Even; PinHeader_2x05_P2.54mm_Vertical
R1, R2, R3, R4, R5: 10.5K; R_Axial_DIN0207_L6.3mm_D2.5mm_P10.16mm_Horizontal
TP1: TestPoint; TestPoint_Pad_2.0x2.0mm
U1: 74LS161; DIP-16_W7.62mm
U2: W65C02SxP / MC6802 / R6502; DIP-40_W15.24mm
U3, U4, U5: 74LS573; DIP-20_W7.62mm
U6: 74LS245; DIP-20_W7.62mm
X1: 8.0 MHz; Oscillator_DIP-14

Connections:
+5V: C1.1, C2.1, C3.1, C4.1, C5.1, C6.1, C7.1, R1.1, R2.1, R3.1, R4.1, R5.1, U1.1 (~MR), U1.3 (D0), U1.4 (D1), U1.5 (D2), U1.6 (D3), U1.7 (CEP), U1.9 (~PE), U1.10 (CET), U1.16 (VCC), U2.8 (VDD), U2.35 ((Vdd)), U2.36 (BE), U3.11 (Load), U3.20 (VCC), U4.11 (Load), U4.20 (VCC), U5.7 (D5), U5.8 (D6), U5.9 (D7), U5.11 (Load), U5.20 (VCC), U6.20 (VCC), X1.14 (Vcc); also elsewhere on the board
/1M: J2.7, U1.12 (Q2)
/2M: J2.5, U1.13 (Q1)
/4M: J2.3, U1.14 (Q0)
/8M: J2.1, U1.2 (CP), X1.8 (OUT)
/500K: J2.9, U1.11 (Q3)
/A0: U2.9 (A0), U3.9 (D7)
/A1: U2.10 (A1), U3.8 (D6)
/A2: U2.11 (A2), U3.7 (D5)
/A3: U2.12 (A3), U3.6 (D4)
/A4: U2.13 (A4), U3.5 (D3)
/A5: U2.14 (A5), U3.4 (D2)
/A6: U2.15 (A6), U3.3 (D1)
/A7: U2.16 (A7), U3.2 (D0)
/A8: U2.17 (A8), U4.9 (D7)
/A9: U2.18 (A9), U4.8 (D6)
/A10: U2.19 (A10), U4.7 (D5)
/A11: U2.20 (A11), U4.6 (D4)
/A12: U2.22 (A12), U4.5 (D3)
/A13: U2.23 (A13), U4.4 (D2)
/A14: U2.24 (A14), U4.3 (D1)
/A15: U2.25 (A15), U4.2 (D0)
/D0: U2.33 (D0), U6.9 (A7)
/D1: U2.32 (D1), U6.8 (A6)
/D2: U2.31 (D2), U6.7 (A5)
/D3: U2.30 (D3), U6.6 (A4)
/D4: U2.29 (D4), U6.5 (A3)
/D5: U2.28 (D5), U6.4 (A2)
/D6: U2.27 (D6), U6.3 (A1)
/D7: U2.26 (D7), U6.2 (A0)
BUS_DIR: U6.1 (A->B); also elsewhere on the board
B_A0: U3.12 (Q7); also elsewhere on the board
B_A1: U3.13 (Q6); also elsewhere on the board
B_A2: U3.14 (Q5); also elsewhere on the board
B_A3: U3.15 (Q4); also elsewhere on the board
B_A4: U3.16 (Q3); also elsewhere on the board
B_A5: U3.17 (Q2); also elsewhere on the board
B_A6: U3.18 (Q1); also elsewhere on the board
B_A7: U3.19 (Q0); also elsewhere on the board
B_A8: U4.12 (Q7); also elsewhere on the board
B_A9: U4.13 (Q6); also elsewhere on the board
B_A10: U4.14 (Q5); also elsewhere on the board
B_A11: U4.15 (Q4); also elsewhere on the board
B_A12: U4.16 (Q3); also elsewhere on the board
B_A13: U4.17 (Q2); also elsewhere on the board
B_A14: U4.18 (Q1); also elsewhere on the board
B_A15: U4.19 (Q0); also elsewhere on the board
B_D0: U6.11 (B7); also elsewhere on the board
B_D1: U6.12 (B6); also elsewhere on the board
B_D2: U6.13 (B5); also elsewhere on the board
B_D3: U6.14 (B4); also elsewhere on the board
B_D4: U6.15 (B3); also elsewhere on the board
B_D5: U6.16 (B2); also elsewhere on the board
B_D6: U6.17 (B1); also elsewhere on the board
B_D7: U6.18 (B0); also elsewhere on the board
B_ECLK: U5.19 (Q0); also elsewhere on the board
CLK: J2.2, J2.4, J2.6, J2.8, J2.10; also elsewhere on the board
CLK_37: U2.37 (ϕ0); also elsewhere on the board
CLK_39: U2.39 (ϕ2); also elsewhere on the board
ECLK: U5.2 (D0); also elsewhere on the board
GND: C1.2, C2.2, C3.2, C4.2, C5.2, C6.2, C7.2, J1.2, TP1.1, U1.8 (GND), U2.21 (VSS), U2.38 (~SO), U3.10 (GND), U4.10 (GND), U5.10 (GND), U6.10 (GND), X1.7 (GND); also elsewhere on the board
unnamed: J1.1, U2.1 (~VP)
unnamed: R2.2, U2.2 (RDY)
unnamed: R3.2, U2.6 (~NMI)
unnamed: R4.2, U2.3 (ϕ1)
R/~W: U2.34 (R/~W); also elsewhere on the board
~BD_EN: U3.1 (OE), U4.1 (OE), U5.1 (OE); also elsewhere on the board
~BUS_EN: U6.19 (CE); also elsewhere on the board
~B_IO: U5.15 (Q4); also elsewhere on the board
~B_RAM: U5.16 (Q3); also elsewhere on the board
~B_RD: U5.17 (Q2); also elsewhere on the board
~B_WR: U5.18 (Q1); also elsewhere on the board
~IO: U5.6 (D4); also elsewhere on the board
~IRQ: U2.4 (~IRQ); also elsewhere on the board
~MEM: R1.2, U2.5 (~ML); also elsewhere on the board
~RAM: U5.5 (D3); also elsewhere on the board
~RD: U5.4 (D2); also elsewhere on the board
~RESET: R5.2, U2.40 (~RES); also elsewhere on the board
~WR: U5.3 (D1); also elsewhere on the board

Notes on the sheet:
No jumper for 65C02. Jumper required for 6502 & 6802

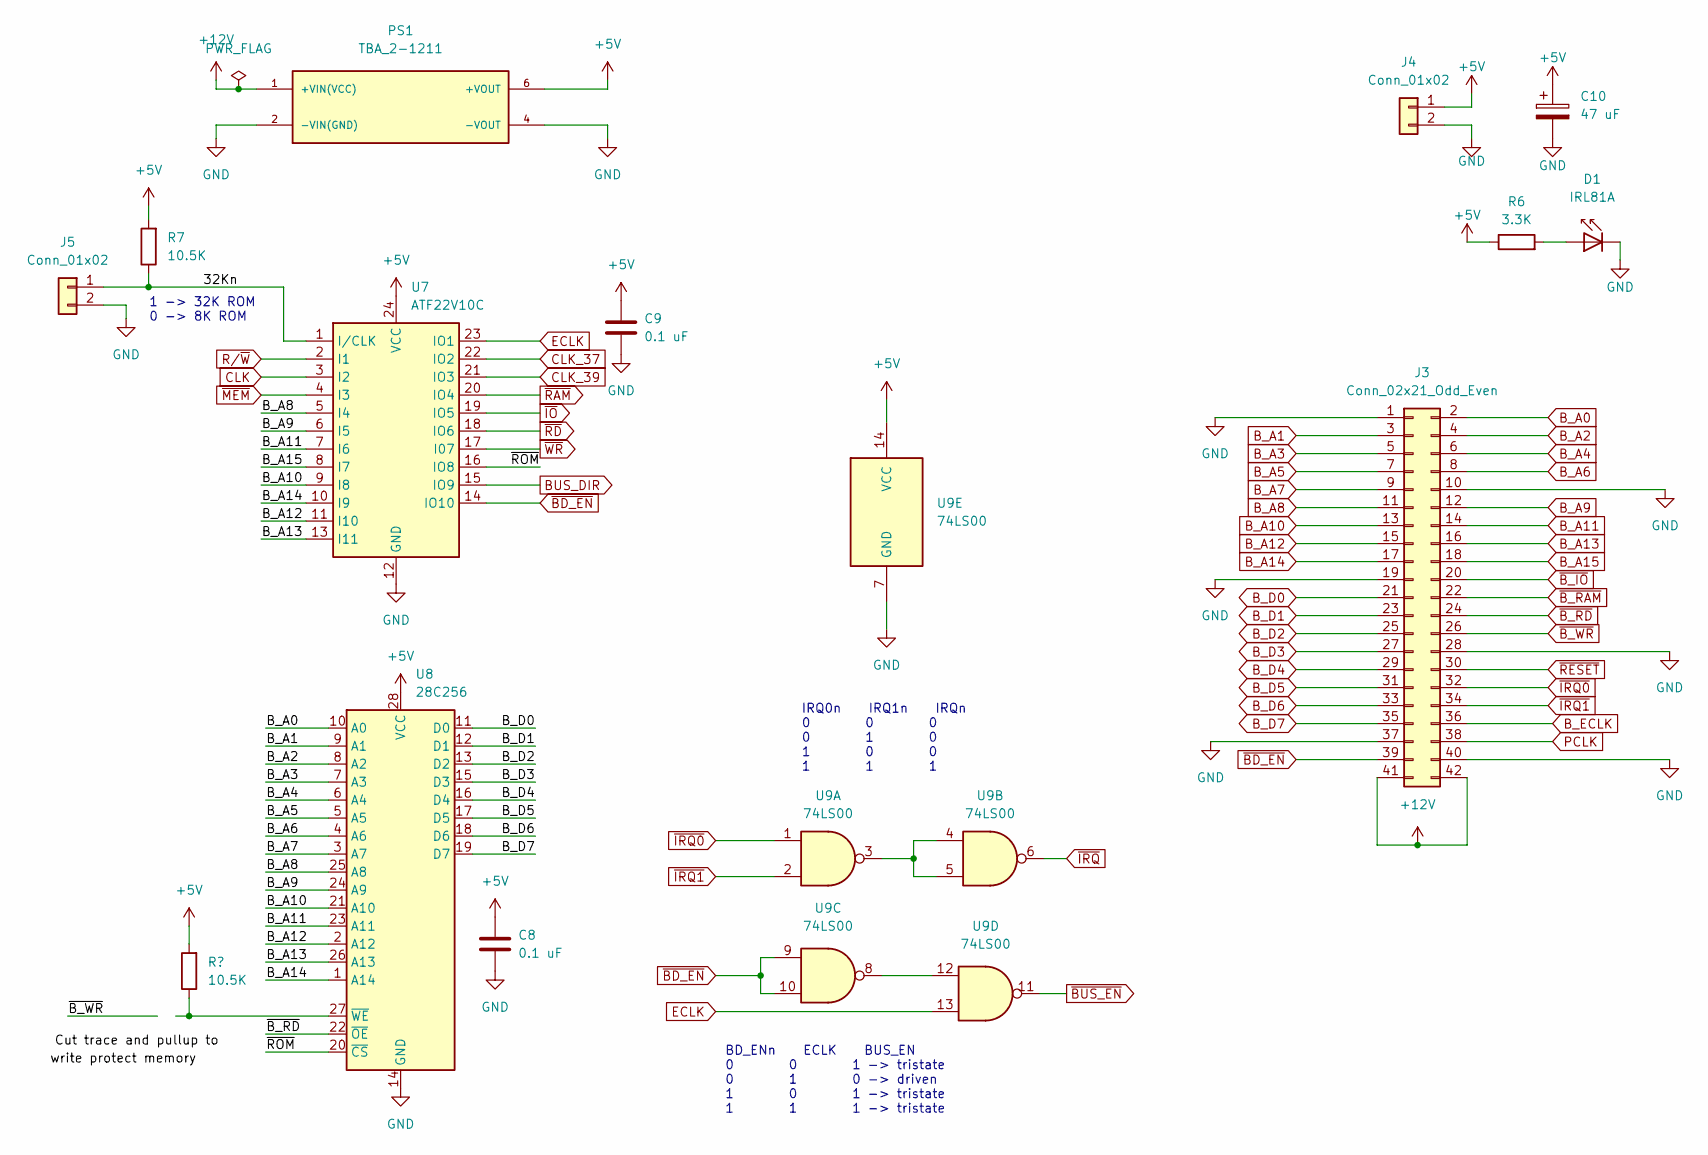
[picture p18: schematic mem_conn.kicad_sch]

Parts:
C8, C9: 0.1 uF; C_Rect_L7.2mm_W3.0mm_P5.00mm_FKS2_FKP2_MKS2_MKP2
C10: 47 uF; CP_Radial_D5.0mm_P2.00mm
D1: IRL81A; LED_D5.0mm
J3: Conn_02x21_Odd_Even; PinHeader_2x21_P2.54mm_Vertical
J4, J5: Conn_01x02; PinHeader_1x02_P2.54mm_Vertical
PS1: TBA_2-1211; CONV_TBA_2-1211; PARTREV April 19, 2021
R6: 3.3K; R_Axial_DIN0207_L6.3mm_D2.5mm_P10.16mm_Horizontal
R7: 10.5K; R_Axial_DIN0207_L6.3mm_D2.5mm_P10.16mm_Horizontal
U7: ATF22V10C; DIP-24_W7.62mm
U8: 28C256; DIP-28_W15.24mm
U9: 74LS00; DIP-14_W7.62mm

Connections:
+5V: C8.1, C9.1, C10.1, J4.1, PS1.6 (+VOUT), R6.1, R7.2, U7.24 (VCC), U8.28 (VCC), U9.14 (VCC); also elsewhere on the board
+12V: J3.41, J3.42, PS1.1 (+VIN(VCC))
/MEM_CONN/32Kn: J5.1, R7.1, U7.1 (I/CLK)
/MEM_CONN/~ROM: U7.16 (IO8), U8.20 (~CS)
BUS_DIR: U7.15 (IO9); also elsewhere on the board
B_A0: J3.2, U8.10 (A0); also elsewhere on the board
B_A1: J3.3, U8.9 (A1); also elsewhere on the board
B_A2: J3.4, U8.8 (A2); also elsewhere on the board
B_A3: J3.5, U8.7 (A3); also elsewhere on the board
B_A4: J3.6, U8.6 (A4); also elsewhere on the board
B_A5: J3.7, U8.5 (A5); also elsewhere on the board
B_A6: J3.8, U8.4 (A6); also elsewhere on the board
B_A7: J3.9, U8.3 (A7); also elsewhere on the board
B_A8: J3.11, U7.5 (I4), U8.25 (A8); also elsewhere on the board
B_A9: J3.12, U7.6 (I5), U8.24 (A9); also elsewhere on the board
B_A10: J3.13, U7.9 (I8), U8.21 (A10); also elsewhere on the board
B_A11: J3.14, U7.7 (I6), U8.23 (A11); also elsewhere on the board
B_A12: J3.15, U7.11 (I10), U8.2 (A12); also elsewhere on the board
B_A13: J3.16, U7.13 (I11), U8.26 (A13); also elsewhere on the board
B_A14: J3.17, U7.10 (I9), U8.1 (A14); also elsewhere on the board
B_A15: J3.18, U7.8 (I7); also elsewhere on the board
B_D0: J3.21, U8.11 (D0); also elsewhere on the board
B_D1: J3.23, U8.12 (D1); also elsewhere on the board
B_D2: J3.25, U8.13 (D2); also elsewhere on the board
B_D3: J3.27, U8.15 (D3); also elsewhere on the board
B_D4: J3.29, U8.16 (D4); also elsewhere on the board
B_D5: J3.31, U8.17 (D5); also elsewhere on the board
B_D6: J3.33, U8.18 (D6); also elsewhere on the board
B_D7: J3.35, U8.19 (D7); also elsewhere on the board
B_ECLK: J3.36; also elsewhere on the board
CLK: U7.3 (I2); also elsewhere on the board
CLK_37: U7.22 (IO2); also elsewhere on the board
CLK_39: U7.21 (IO3); also elsewhere on the board
ECLK: U7.23 (IO1), U9.13; also elsewhere on the board
GND: C8.2, C9.2, C10.2, D1.1 (K), J3.1, J3.10, J3.19, J3.28, J3.37, J3.40, J4.2, J5.2, PS1.2 (-VIN(GND)), PS1.4 (-VOUT), U7.12 (GND), U8.14 (GND), U9.7 (GND); also elsewhere on the board
unnamed: D1.2 (A), R6.2
unnamed: U9.3, U9.4, U9.5
unnamed: U9.8, U9.12
PCLK: J3.38
R/~W: U7.2 (I1); also elsewhere on the board
~BD_EN: J3.39, U7.14 (IO10), U9.9, U9.10; also elsewhere on the board
~BUS_EN: U9.11; also elsewhere on the board
~B_IO: J3.20; also elsewhere on the board
~B_RAM: J3.22; also elsewhere on the board
~B_RD: J3.24, U8.22 (~OE); also elsewhere on the board
~B_WR: J3.26, U8.27 (~WE); also elsewhere on the board
~IO: U7.19 (IO5); also elsewhere on the board
~IRQ0: J3.32, U9.1
~IRQ1: J3.34, U9.2
~IRQ: U9.6; also elsewhere on the board
~MEM: U7.4 (I3); also elsewhere on the board
~RAM: U7.20 (IO4); also elsewhere on the board
~RD: U7.18 (IO6); also elsewhere on the board
~RESET: J3.30; also elsewhere on the board
~WR: U7.17 (I07); also elsewhere on the board

Notes on the sheet:
1 -> 32K ROM 0 -> 8K ROM
IRQ0n IRQ1n IRQn 0 0 0 0 1 0 1 0 0 1 1 1
BD_ENn ECLK BUS_EN 0 0 1 -> tristate 0 1 0 -> driven 1 0 1 -> tristate 1 1 1 -> tristate

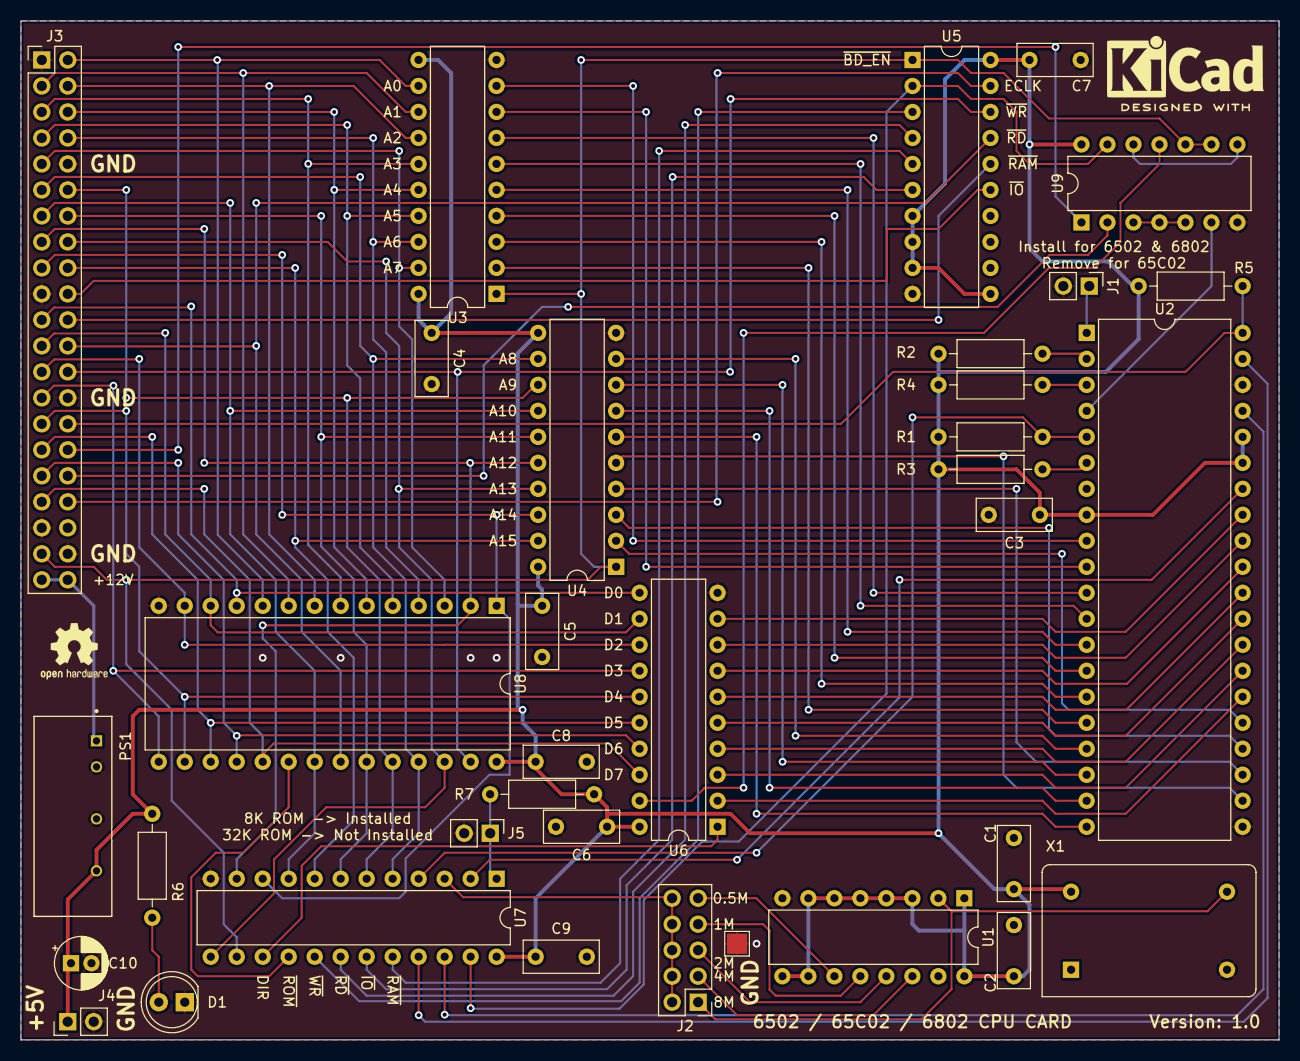
[picture p19: board cpu6502.kicad_pcb from above]

Board: 2 copper layers, 122.9 x 99.6 mm, 35 parts (0 on the bottom side), 87 nets.
