nandgate/Homebrew-HW/mainBoard/mainBoard.kicad_pcb

## KiCad design mainBoard/mainBoard.kicad_pcb (2022-08-10)

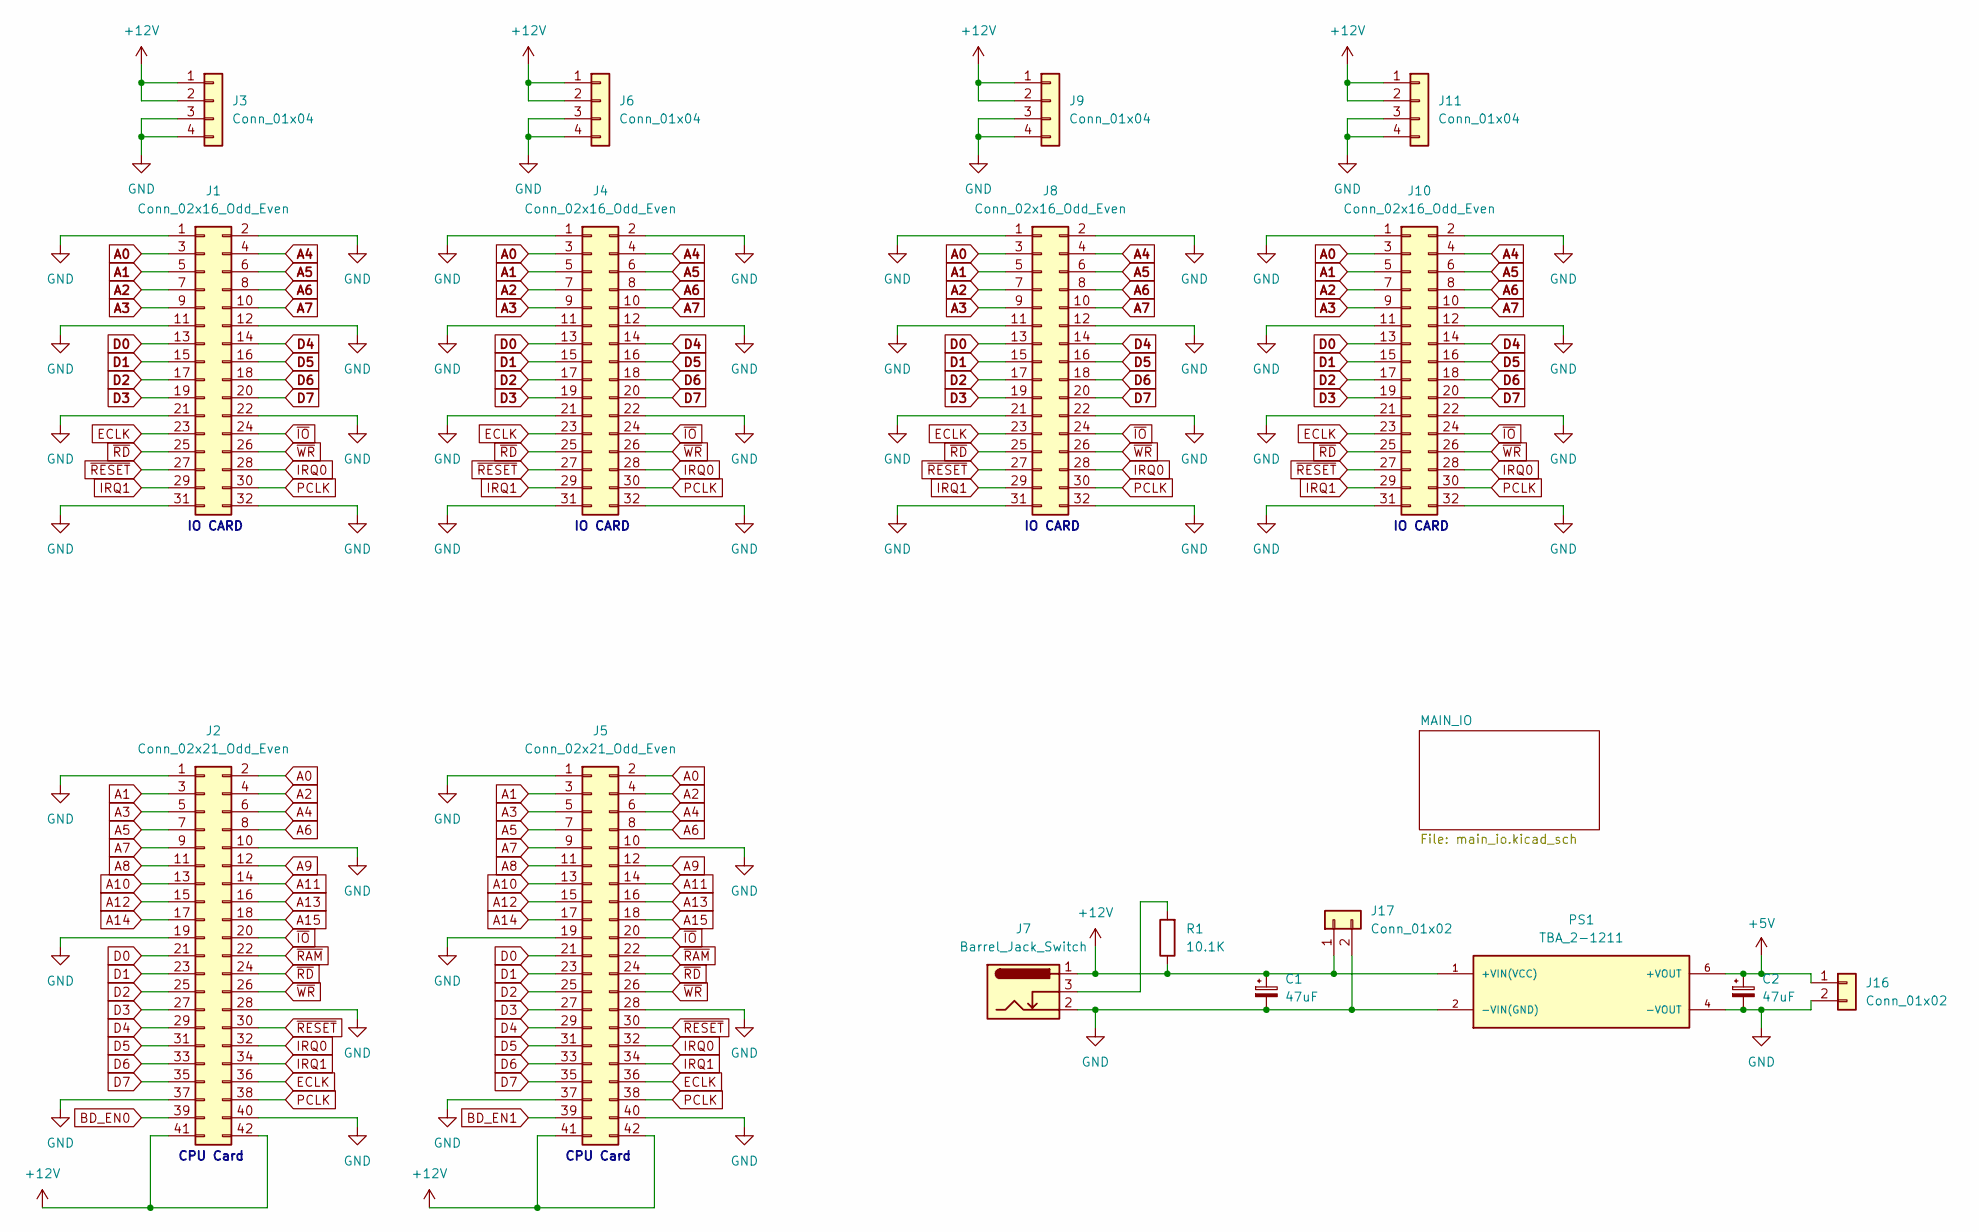
[picture p20: schematic mainBoard.kicad_sch]

Parts:
C1, C2: 47uF; CP_Radial_D5.0mm_P2.00mm
J1, J4, J8, J10: Conn_02x16_Odd_Even; PinSocket_2x16_P2.54mm_Vertical
J2, J5: Conn_02x21_Odd_Even; PinSocket_2x21_P2.54mm_Vertical
J3, J6, J9, J11: Conn_01x04; PinSocket_1x04_P2.54mm_Vertical
J7: Barrel_Jack_Switch; BarrelJack_Wuerth_6941xx301002
J16, J17: Conn_01x02; PinHeader_1x02_P2.54mm_Vertical
PS1: TBA_2-1211; CONV_TBA_2-1211; PARTREV April 19, 2021
R1: 10.1K; R_Axial_DIN0207_L6.3mm_D2.5mm_P10.16mm_Horizontal

Connections:
+5V: C2.1, J16.1, PS1.6 (+VOUT); also elsewhere on the board
+12V: C1.1, J2.41, J2.42, J3.1, J3.2, J5.41, J5.42, J6.1, J6.2, J7.1, J9.1, J9.2, J11.1, J11.2, J17.1, PS1.1 (+VIN(VCC)), R1.1
A0: J1.3, J2.2, J4.3, J5.2, J8.3, J10.3; also elsewhere on the board
A1: J1.5, J2.3, J4.5, J5.3, J8.5, J10.5; also elsewhere on the board
A2: J1.7, J2.4, J4.7, J5.4, J8.7, J10.7; also elsewhere on the board
A3: J1.9, J2.5, J4.9, J5.5, J8.9, J10.9; also elsewhere on the board
A4: J1.4, J2.6, J4.4, J5.6, J8.4, J10.4; also elsewhere on the board
A5: J1.6, J2.7, J4.6, J5.7, J8.6, J10.6; also elsewhere on the board
A6: J1.8, J2.8, J4.8, J5.8, J8.8, J10.8; also elsewhere on the board
A7: J1.10, J2.9, J4.10, J5.9, J8.10, J10.10; also elsewhere on the board
A8: J2.11, J5.11; also elsewhere on the board
A9: J2.12, J5.12; also elsewhere on the board
A10: J2.13, J5.13; also elsewhere on the board
A11: J2.14, J5.14; also elsewhere on the board
A12: J2.15, J5.15; also elsewhere on the board
A13: J2.16, J5.16; also elsewhere on the board
A14: J2.17, J5.17; also elsewhere on the board
A15: J2.18, J5.18; also elsewhere on the board
BD_EN0: J2.39; also elsewhere on the board
BD_EN1: J5.39; also elsewhere on the board
D0: J1.13, J2.21, J4.13, J5.21, J8.13, J10.13; also elsewhere on the board
D1: J1.15, J2.23, J4.15, J5.23, J8.15, J10.15; also elsewhere on the board
D2: J1.17, J2.25, J4.17, J5.25, J8.17, J10.17; also elsewhere on the board
D3: J1.19, J2.27, J4.19, J5.27, J8.19, J10.19; also elsewhere on the board
D4: J1.14, J2.29, J4.14, J5.29, J8.14, J10.14; also elsewhere on the board
D5: J1.16, J2.31, J4.16, J5.31, J8.16, J10.16; also elsewhere on the board
D6: J1.18, J2.33, J4.18, J5.33, J8.18, J10.18; also elsewhere on the board
D7: J1.20, J2.35, J4.20, J5.35, J8.20, J10.20; also elsewhere on the board
ECLK: J1.23, J2.36, J4.23, J5.36, J8.23, J10.23; also elsewhere on the board
GND: C1.2, C2.2, J1.1, J1.2, J1.11, J1.12, J1.21, J1.22, J1.31, J1.32, J2.1, J2.10, J2.19, J2.28, J2.37, J2.40, J3.3, J3.4, J4.1, J4.2, J4.11, J4.12, J4.21, J4.22, J4.31, J4.32, J5.1, J5.10, J5.19, J5.28, J5.37, J5.40, J6.3, J6.4, J7.2, J8.1, J8.2, J8.11, J8.12, J8.21, J8.22, J8.31, J8.32, J9.3, J9.4, J10.1, J10.2, J10.11, J10.12, J10.21, J10.22, J10.31, J10.32, J11.3, J11.4, J16.2, J17.2, PS1.2 (-VIN(GND)), PS1.4 (-VOUT); also elsewhere on the board
IRQ0: J1.28, J2.32, J4.28, J5.32, J8.28, J10.28; also elsewhere on the board
IRQ1: J1.29, J2.34, J4.29, J5.34, J8.29, J10.29; also elsewhere on the board
unnamed: J7.3, R1.2
PCLK: J1.30, J2.38, J4.30, J5.38, J8.30, J10.30
~IO: J1.24, J2.20, J4.24, J5.20, J8.24, J10.24; also elsewhere on the board
~RAM: J2.22, J5.22; also elsewhere on the board
~RD: J1.25, J2.24, J4.25, J5.24, J8.25, J10.25; also elsewhere on the board
~RESET: J1.27, J2.30, J4.27, J5.30, J8.27, J10.27; also elsewhere on the board
~WR: J1.26, J2.26, J4.26, J5.26, J8.26, J10.26; also elsewhere on the board

Notes on the sheet:
CPU Card
IO CARD

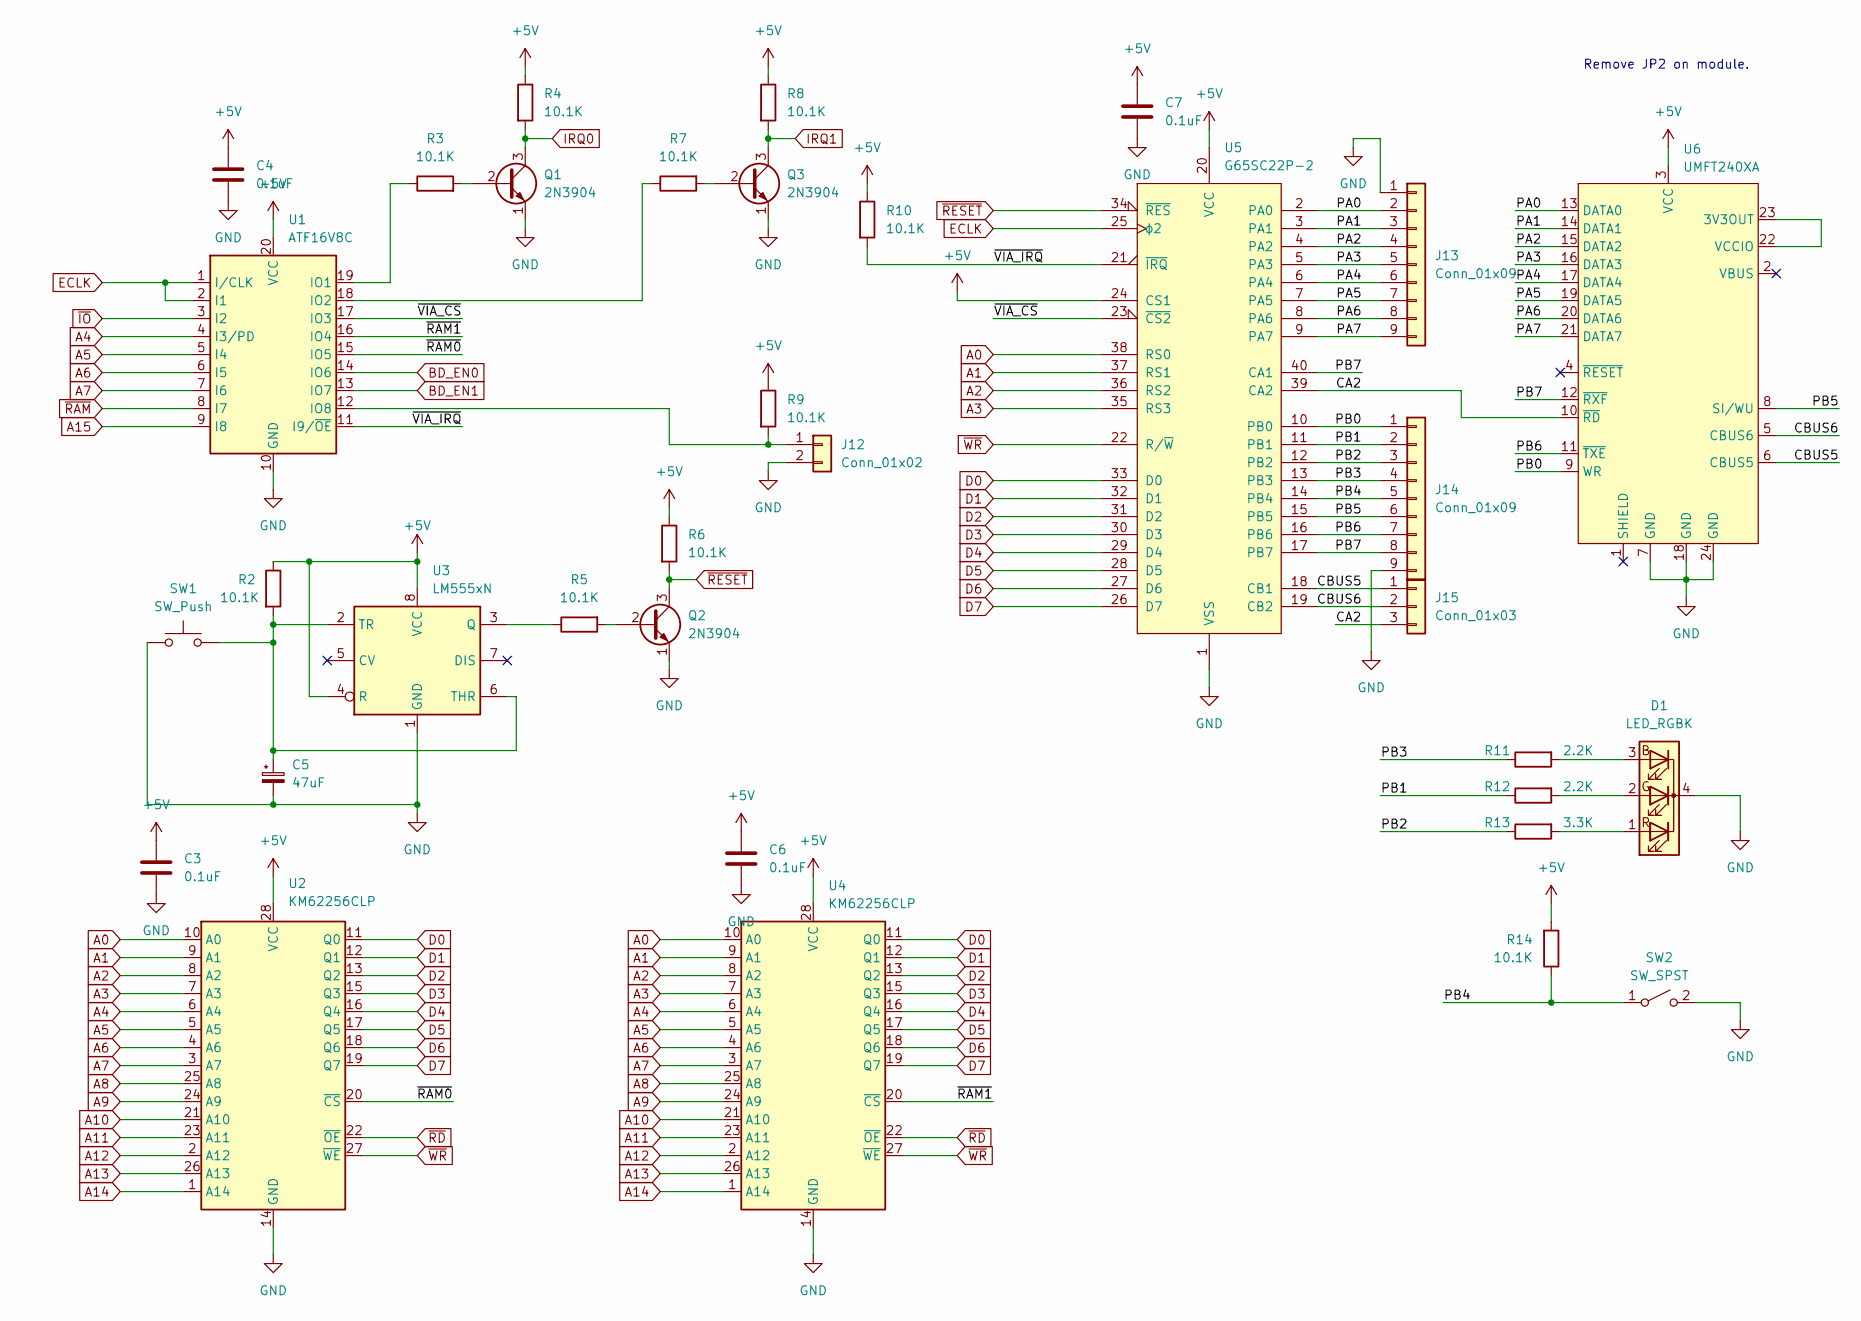
[picture p21: schematic main_io.kicad_sch]

Parts:
C3, C4, C6, C7: 0.1uF; C_Rect_L7.0mm_W2.5mm_P5.00mm
C5: 47uF; CP_Radial_D5.0mm_P2.00mm
D1: LED_RGBK; RGB_SMD_W7.8_H7.9
J12: Conn_01x02; PinHeader_1x02_P2.54mm_Vertical
J13, J14: Conn_01x09; PinHeader_1x09_P2.54mm_Vertical
J15: Conn_01x03; PinHeader_1x03_P2.54mm_Vertical
Q1, Q2, Q3: 2N3904; TO-92_Inline
R2, R3, R4, R5, R6, R7, R8, R9, R10, R14: 10.1K; R_Axial_DIN0207_L6.3mm_D2.5mm_P10.16mm_Horizontal
R11, R12: 2.2K; R_Axial_DIN0207_L6.3mm_D2.5mm_P10.16mm_Horizontal
R13: 3.3K; R_Axial_DIN0207_L6.3mm_D2.5mm_P10.16mm_Horizontal
SW1: SW_Push; SW_PUSH_6mm
SW2: SW_SPST; SW_DIP_SPSTx01_Slide_9.78x4.72mm_W7.62mm_P2.54mm
U1: ATF16V8C; DIP-20_W7.62mm_Socket_LongPads
U2, U4: KM62256CLP; DIP-28_W7.62mm_W15.64mm_LongPads
U3: LM555xN; DIP-8_W7.62mm
U5: G65SC22P-2; DIP-40_W15.24mm_Socket_LongPads
U6: UMFT240XA; DIP-24_W7.62mm_Socket_LongPads

Connections:
+5V: C3.1, C4.1, C6.1, C7.1, R2.1, R4.1, R6.1, R8.1, R9.1, R10.1, R14.2, U1.20 (VCC), U2.28 (VCC), U3.4 (R), U3.8 (VCC), U4.28 (VCC), U5.20 (VCC), U5.24 (CS1), U6.3 (VCC); also elsewhere on the board
/MAIN_IO/CA2: J15.3, U5.39 (CA2), U6.10 (~RD)
/MAIN_IO/CBUS5: J15.1, U5.18 (CB1), U6.6 (CBUS5)
/MAIN_IO/CBUS6: J15.2, U5.19 (CB2), U6.5 (CBUS6)
/MAIN_IO/PA0: J13.2, U5.2 (PA0), U6.13 (DATA0)
/MAIN_IO/PA1: J13.3, U5.3 (PA1), U6.14 (DATA1)
/MAIN_IO/PA2: J13.4, U5.4 (PA2), U6.15 (DATA2)
/MAIN_IO/PA3: J13.5, U5.5 (PA3), U6.16 (DATA3)
/MAIN_IO/PA4: J13.6, U5.6 (PA4), U6.17 (DATA4)
/MAIN_IO/PA5: J13.7, U5.7 (PA5), U6.19 (DATA5)
/MAIN_IO/PA6: J13.8, U5.8 (PA6), U6.20 (DATA6)
/MAIN_IO/PA7: J13.9, U5.9 (PA7), U6.21 (DATA7)
/MAIN_IO/PB0: J14.1, U5.10 (PB0), U6.9 (WR)
/MAIN_IO/PB1: J14.2, R12.1, U5.11 (PB1)
/MAIN_IO/PB2: J14.3, R13.1, U5.12 (PB2)
/MAIN_IO/PB3: J14.4, R11.1, U5.13 (PB3)
/MAIN_IO/PB4: J14.5, R14.1, SW2.1 (A), U5.14 (PB4)
/MAIN_IO/PB5: J14.6, U5.15 (PB5), U6.8 (SI/WU)
/MAIN_IO/PB6: J14.7, U5.16 (PB6), U6.11 (~TXE)
/MAIN_IO/PB7: J14.8, U5.17 (PB7), U5.40 (CA1), U6.12 (~RXF)
/MAIN_IO/~RAM0: U1.15 (IO5), U2.20 (~CS)
/MAIN_IO/~RAM1: U1.16 (IO4), U4.20 (~CS)
/MAIN_IO/~VIA_CS: U1.17 (IO3), U5.23 (~CS2)
/MAIN_IO/~VIA_IRQ: R10.2, U1.11 (I9/~OE), U5.21 (~IRQ)
A0: U2.10 (A0), U4.10 (A0), U5.38 (RS0); also elsewhere on the board
A1: U2.9 (A1), U4.9 (A1), U5.37 (RS1); also elsewhere on the board
A2: U2.8 (A2), U4.8 (A2), U5.36 (RS2); also elsewhere on the board
A3: U2.7 (A3), U4.7 (A3), U5.35 (RS3); also elsewhere on the board
A4: U1.4 (I3/PD), U2.6 (A4), U4.6 (A4); also elsewhere on the board
A5: U1.5 (I4), U2.5 (A5), U4.5 (A5); also elsewhere on the board
A6: U1.6 (I5), U2.4 (A6), U4.4 (A6); also elsewhere on the board
A7: U1.7 (I6), U2.3 (A7), U4.3 (A7); also elsewhere on the board
A8: U2.25 (A8), U4.25 (A8); also elsewhere on the board
A9: U2.24 (A9), U4.24 (A9); also elsewhere on the board
A10: U2.21 (A10), U4.21 (A10); also elsewhere on the board
A11: U2.23 (A11), U4.23 (A11); also elsewhere on the board
A12: U2.2 (A12), U4.2 (A12); also elsewhere on the board
A13: U2.26 (A13), U4.26 (A13); also elsewhere on the board
A14: U2.1 (A14), U4.1 (A14); also elsewhere on the board
A15: U1.9 (I8); also elsewhere on the board
BD_EN0: U1.14 (IO6); also elsewhere on the board
BD_EN1: U1.13 (IO7); also elsewhere on the board
D0: U2.11 (Q0), U4.11 (Q0), U5.33 (D0); also elsewhere on the board
D1: U2.12 (Q1), U4.12 (Q1), U5.32 (D1); also elsewhere on the board
D2: U2.13 (Q2), U4.13 (Q2), U5.31 (D2); also elsewhere on the board
D3: U2.15 (Q3), U4.15 (Q3), U5.30 (D3); also elsewhere on the board
D4: U2.16 (Q4), U4.16 (Q4), U5.29 (D4); also elsewhere on the board
D5: U2.17 (Q5), U4.17 (Q5), U5.28 (D5); also elsewhere on the board
D6: U2.18 (Q6), U4.18 (Q6), U5.27 (D6); also elsewhere on the board
D7: U2.19 (Q7), U4.19 (Q7), U5.26 (D7); also elsewhere on the board
ECLK: U1.1 (I/CLK), U1.2 (I1), U5.25 (ϕ2); also elsewhere on the board
GND: C3.2, C4.2, C5.2, C6.2, C7.2, D1.4 (K), J12.2, J13.1, J14.9, Q1.1 (E), Q2.1 (E), Q3.1 (E), SW1.1, SW2.2 (B), U1.10 (GND), U2.14 (GND), U3.1 (GND), U4.14 (GND), U5.1 (VSS), U6.7 (GND), U6.18 (GND), U6.24 (GND); also elsewhere on the board
IRQ0: Q1.3 (C), R4.2; also elsewhere on the board
IRQ1: Q3.3 (C), R8.2; also elsewhere on the board
unnamed: C5.1, R2.2, SW1.2, U3.2 (TR), U3.6 (THR)
unnamed: D1.1 (RA), R13.2
unnamed: D1.2 (GA), R12.2
unnamed: D1.3 (BA), R11.2
unnamed: J12.1, R9.2, U1.12 (IO8)
unnamed: Q1.2 (B), R3.2
unnamed: Q2.2 (B), R5.2
unnamed: Q3.2 (B), R7.2
unnamed: R3.1, U1.19 (IO1)
unnamed: R5.1, U3.3 (Q)
unnamed: R7.1, U1.18 (IO2)
unnamed: U6.22 (VCCIO), U6.23 (3V3OUT)
~IO: U1.3 (I2); also elsewhere on the board
~RAM: U1.8 (I7); also elsewhere on the board
~RD: U2.22 (~OE), U4.22 (~OE); also elsewhere on the board
~RESET: Q2.3 (C), R6.2, U5.34 (~RES); also elsewhere on the board
~WR: U2.27 (~WE), U4.27 (~WE), U5.22 (R/~W); also elsewhere on the board

Notes on the sheet:
Remove JP2 on module.

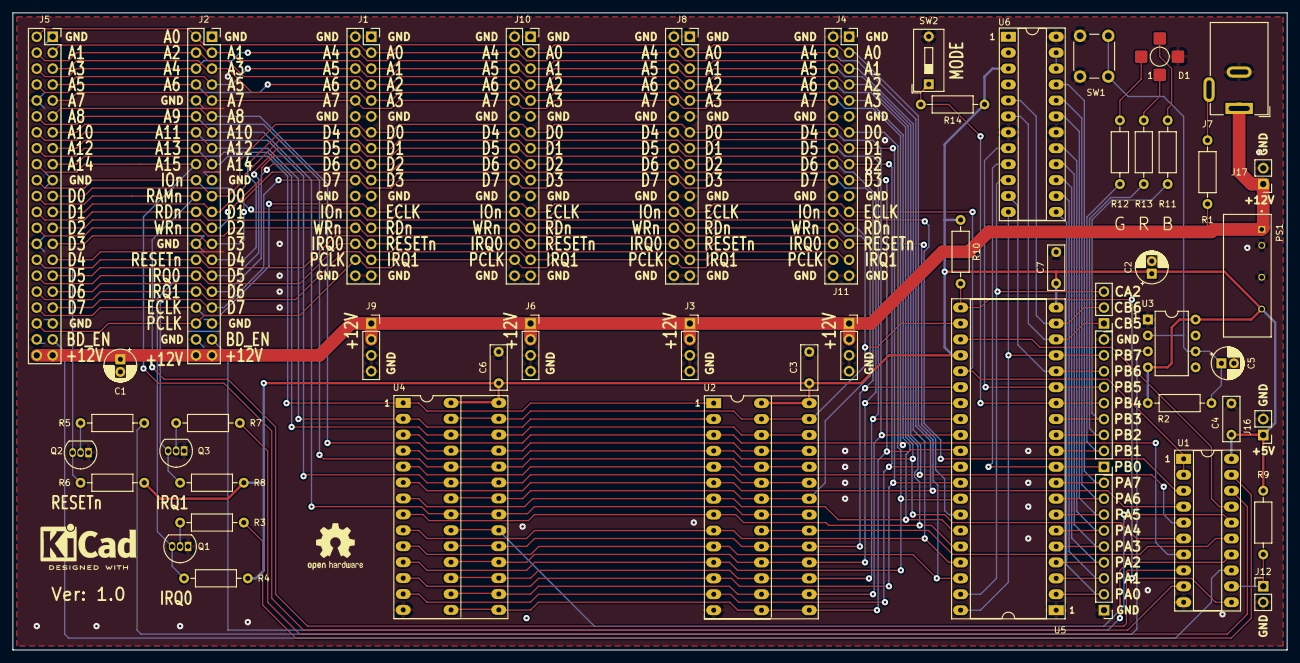
[picture p22: board mainBoard.kicad_pcb from above]

Board: 2 copper layers, 203.2 x 101.6 mm, 51 parts (0 on the bottom side), 74 nets.
