nandgate/Homebrew-HW/(commit log)

2022-08-10 Design and layout for 6502/65C02/8602 processor board.
    [cpu6502.kicad_pcb, cpu6502.kicad_sch, mem_conn.kicad_sch]
2022-08-10 Design and layout of the Main board (as built)
    [mainBoard.kicad_pcb, mainBoard.kicad_sch, main_io.kicad_sch]
2022-08-13 Misc updates to PCB
    [cpu6502.kicad_pcb]
2022-08-25 Moved devices around and size reduced board.
    [cpu6502.kicad_pcb, cpu6502.kicad_sch, mem_conn.kicad_sch]
2022-08-25 Added PLD files for main board.
2022-09-05 Updated to as built.
    [cpu6502.kicad_pcb, cpu6502.kicad_sch, mem_conn.kicad_sch]
2022-09-19 Added Z80 CPU Board
    [cpuZ80.kicad_pcb, cpuZ80.kicad_sch, mem_conn.kicad_sch]
2022-10-09 Created design files for CPU_TESTER
    [CPU_TESTER.kicad_pcb, CPU_TESTER.kicad_sch]
2022-10-13 CPU tester design
    [CPU_TESTER.kicad_pcb, CPU_TESTER.kicad_sch]
2022-12-12 Updated tester schematic, per built
    [CPU_TESTER.kicad_sch]
2022-12-24 Updated voltage monitoring divider to as-built.
    [CPU_TESTER.kicad_sch]
2022-12-24 Added PDF of schematic
2023-04-04 Added 8085 CPU
    [cpu8085.kicad_pcb, cpu8085.kicad_sch, mem_conn.kicad_sch]
